rckTom/RTVC/README.md

# RTVC
RTVC (Rocket Thrust Vector Control)
