rckTom/RTVC/Documentation/99_SOFEX_2018_praesentation/SOFEX_2018_praesentation.pdf

# Entwicklung einer Modellrakete mit Schubvektorsteuerung

# Oliver Arend¹

1Solaris-RMB e.V.

# Göttingen, 11. Februar 2018

Oliver Arend, Solaris-RMB e.V. | Schubvektorsteuerung | 2018–02–11 | 1 / 22

# Übersicht

1 | Zielsetzung
2 | Mechanik
3 | Elektronik
4 | Simulation
5 | Firmware
6 | Ergebnisse
Oliver Arend, Solaris-RMB e.V. | Schubvektorsteuerung | 2018–02–11 | 2 / 22

# Zielsetzung

# Aktiv stabilisierte Rakete durch Schubvektorsteuerung

Günstige, einfach erhältliche Komponenten, z. B.

## Arduino Modellbau-Servos

# Einfach nachzubauen

# Erfahrungen für größere, komplexere Raketen nutzen

# Alle notwendigen Informationen öffentlich verfügbar machen

Oliver Arend, Solaris-RMB e.V. | Schubvektorsteuerung | 2018–02–11 | 3 / 22

Was bisher geschah ...

# Vorführung einer Schubvektorrakete durch Wolfgang Lang beim Flugtag in Manching 2015 (und seitdem immer wieder)

# Mehrere Iterationen für das Strukturdesign:

Werkstoff? Balsa, Pappelsperrholz, CfK ...
Herstellung? Laserschneiden, Fräsen, ...

## Aktueller Stand: größtenteils gefrästes Flugzeugsperrholz, teilweise 3D-Druck

# Berechnung der aerodynamischen Beiwerte mit CFD

# Erstellung eines einfachen regelungstechnischen Modells

# Umsetzung in Firmware

# Probeflug

Oliver Arend, Solaris-RMB e.V. | Schubvektorsteuerung | 2018–02–11 | 4 / 22

# Einzelteile kardanische Aufhängung


Oliver Arend, Solaris-RMB e.V. | Schubvektorsteuerung | 2018–02–11 | 5 / 22

# Motorhalterung


Oliver Arend, Solaris-RMB e.V. | Schubvektorsteuerung | 2018–02–11 | 6 / 22

# Servos und Halterungen


Oliver Arend, Solaris-RMB e.V. | Schubvektorsteuerung | 2018–02–11 | 7 / 22

# Servos montiert


Oliver Arend, Solaris-RMB e.V. | Schubvektorsteuerung | 2018–02–11 | 8 / 22

# Servos und Motorhalterung


Oliver Arend, Solaris-RMB e.V. | Schubvektorsteuerung | 2018–02–11 | 9 / 22

# Stringer-Struktur

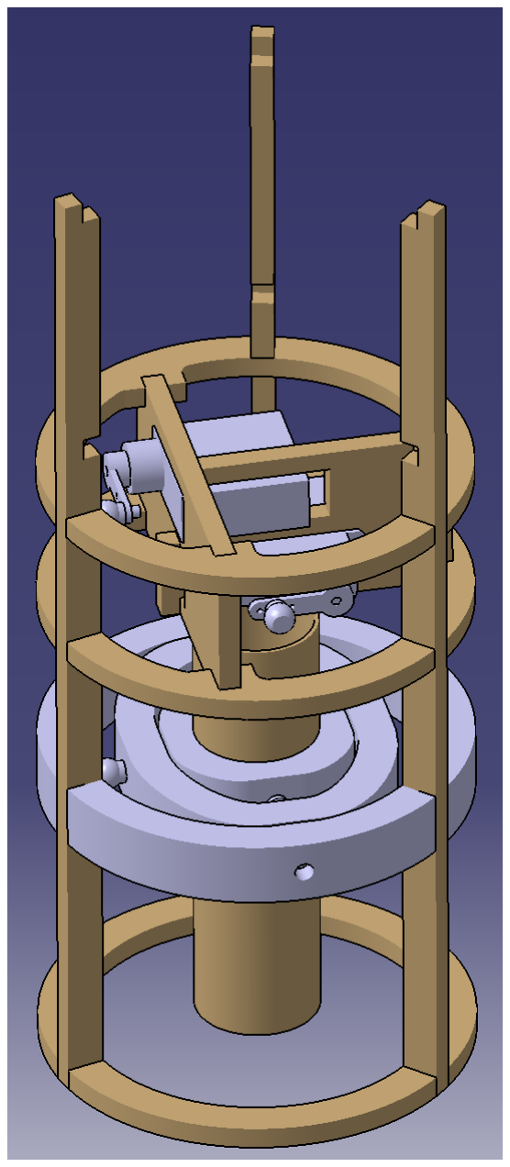
[picture p24: figure]

Oliver Arend, Solaris-RMB e.V. | Schubvektorsteuerung | 2018–02–11 | 10 / 22

# Elektronik-Komponenten


Oliver Arend, Solaris-RMB e.V. | Schubvektorsteuerung | 2018–02–11 | 11 / 22

# Elektronik montiert – ohne Kabelsalat

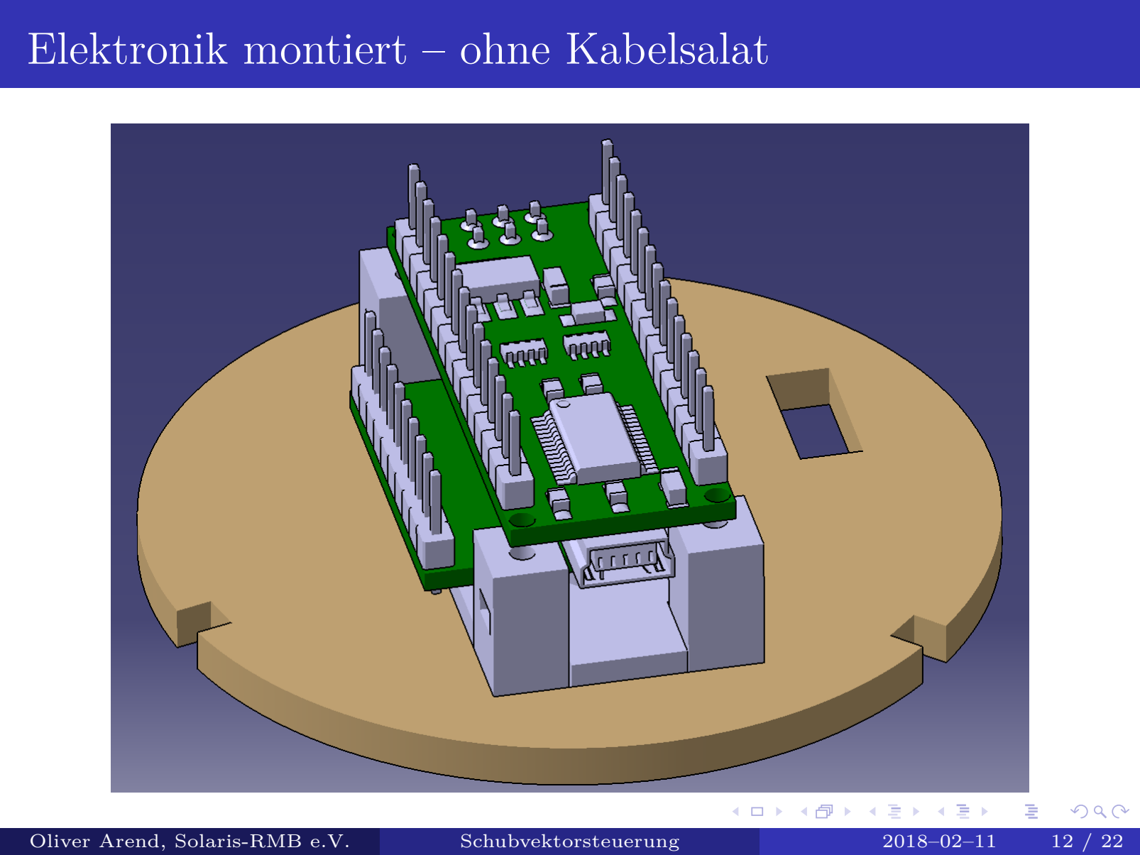
[picture p25: page 12]

Oliver Arend, Solaris-RMB e.V. | Schubvektorsteuerung | 2018–02–11 | 12 / 22

# Struktur komplett

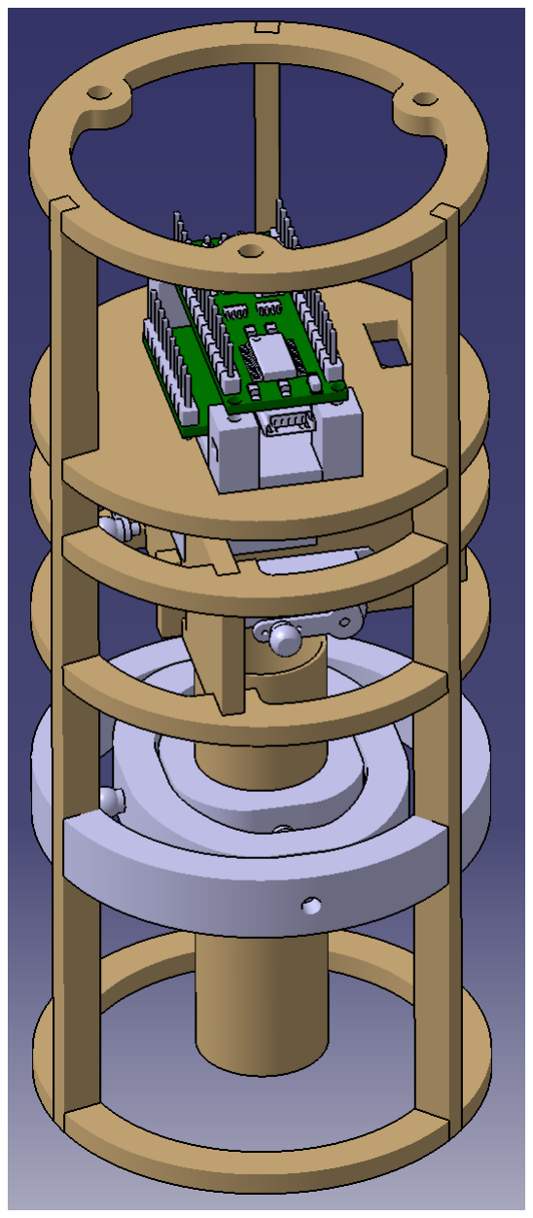
[picture p26: figure]

Oliver Arend, Solaris-RMB e.V. | Schubvektorsteuerung | 2018–02–11 | 13 / 22

# Elektronik

Batterie | BEC | Arduino Nano | GY-80 IMU
Servo X | Servo Y

# Ausstoßladung

Oliver Arend, Solaris-RMB e.V. | Schubvektorsteuerung | 2018–02–11 | 14 / 22

# Modellbildung


Oliver Arend, Solaris-RMB e.V. | Schubvektorsteuerung | 2018–02–11 | 15 / 22

# Servoverhalten


Oliver Arend, Solaris-RMB e.V. | Schubvektorsteuerung | 2018–02–11 | 16 / 22

# Vorhergesagte Reaktion auf Anstellwinkeländerung

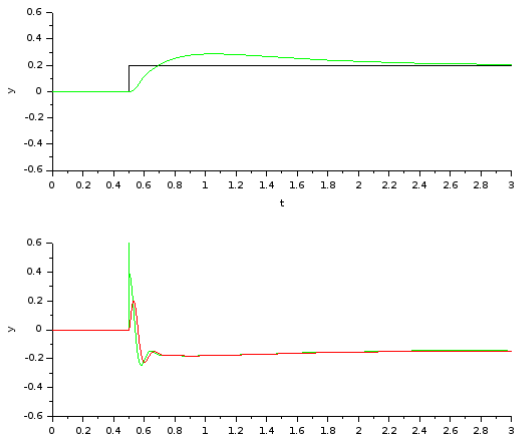
[picture p27: figure]

KP = 2,0; | KI = 1,8; | KD = 0,3
Oliver Arend, Solaris-RMB e.V. | Schubvektorsteuerung | 2018–02–11 | 17 / 22

# Firmware

# State Machine mit drei Zuständen

# Ausführen der einzelnen Operationen alle 10 ms mittels Interrupt

1 ON_RAMP Messung der Beschleunigung in z-Richtung Messung der Drehraten um x- und y-Achsen Laufende Bildung von Mittelwerten für alle Messgrößen für Korrektur der Werte im Flug Überwachen der Beschleunigung, bei Überschreiten von 20 m/s

2
| Wechsel zu IN_FLIGHT
Oliver Arend, Solaris-RMB e.V. | Schubvektorsteuerung | 2018–02–11 | 18 / 22

# Firmware

## 2 IN_FLIGHT Flugzustandsschätzung mittels Kalman-Filter Vorhersage, z. B. für Flughöhe

## ˆhi+1 = hi + ∆t vi +

1
2∆t

2
ai | (1)
vˆi+1 | = vi + ∆tai | (2)
aˆi+1 | = ai | (3)

## Korrektur

| ai+1 = (1 − Ka)ˆai+1 + Kaa˜ | | (4)

## Kalman-Gains wurden offline mit simulierten Werten ermittelt Berechnung der Soll-Position u des Servos der jeweiligen Achse anhand des Fehlers

Eγ | = Eγ + ∆t γ | (5)
| u = KP γ + KI Eγ + KD γ˙ | | (6)

## Wechsel zu RECOVERY wenn ein Bahnwinkel 90◦ überschreitet oder die Geschwindigkeit unter 0 fällt

Oliver Arend, Solaris-RMB e.V. | Schubvektorsteuerung | 2018–02–11 | 19 / 22

# Firmware

3 | RECOVERY Pin für Ausstoßladung für 1 Sekunde auf HIGH setzen Servos auf Mittelposition stellen Bis in alle Ewigkeit die LED blinken lassen ...
Oliver Arend, Solaris-RMB e.V. | Schubvektorsteuerung | 2018–02–11 | 20 / 22

# Probeflug

Werdet Ihr gleich sehen ...

Oliver Arend, Solaris-RMB e.V. | Schubvektorsteuerung | 2018–02–11 | 21 / 22

# Offene Fragen

# Sind die Servos gut geeignet (Zittern)?

# Ist die Motoransteuerung verbesserungsfähig?

# Wie kann das Design vor allem hinsichtlich Montage verbessert werden?

# Gibt es bessere (geeignete) Sensoren?

# Ist der Kalman-Filter richtig eingestellt?

# Muss der Regler besser eingestellt werden?

Oliver Arend, Solaris-RMB e.V. | Schubvektorsteuerung | 2018–02–11 | 22 / 22
