rckTom/RTVC/Design/Mechanik/teiledurchmesser.xls

 |  |  | v2 |  |  | v2.1
 | D | R |  | D | R |  | D | R
Motor außen | 24 | 12 | Motor außen | 24 | 12 | Motor außen | 24 | 12
Motorrohr außen | 25.5 | 12.75 | Motorrohr außen | 25.5 | 12.75 | Motorrohr außen | 25.5 | 12.75
Innerer Träger Kugelkopfaufnahme | 31.5 | 15.75 | Innerer Träger Ring innen | 25.5 | 12.75 | Innerer Träger Ring innen | 25.5 | 12.75
Innerer Träger Stiftaufnahme | 40.5 | 20.25 | Innerer Träger Ring außen | 31.5 | 15.75 | Innerer Träger Ring außen | 31.5 | 15.75
Äußerer Träger innen | 42.5 | 21.25 | Innerer Träger Kugelkopf | 40.5 | 20.25 | Innerer Träger Kugelkopf | 40.5 | 20.25
Äußerer Träger Kugelkopfaufnahme | 48.5 | 24.25 | Äußerer Träger kurze Achse innen | 33.5 | 16.75 | Äußerer Träger kurze Achse innen | 32 | 16
Äußerer Träger Stiftaufnahme | 57.5 | 28.75 | Äußerer Träger kurze Achse außen | 39.5 | 19.75 | Äußerer Träger kurze Achse außen | 28 | 14
Ringträger innen | 59.5 | 29.75 | Äußerer Träger Kugelkopf | 48.5 | 24.25 | Äußerer Träger Kugelkopf | 47 | 23.5
Ringträger außen | 74.5 | 37.25 | Äußerer Träger lange Achse innen | 42.5 | 21.25 | Äußerer Träger lange Achse innen | 42.5 | 21.25
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
