rckTom/RTVC/Documentation/rtvc.pdf

# Todo list

o | Mit der aktuellen Geometrie von Oliver abgleichen | | 2
o | Koordinatensysteme definieren | | 10
o | Welche Eulerwinkel sollen verwendet werden? Luftfahrtnorm? | | 11
o | Quaternionen beschreiben und einpflegen | | 11

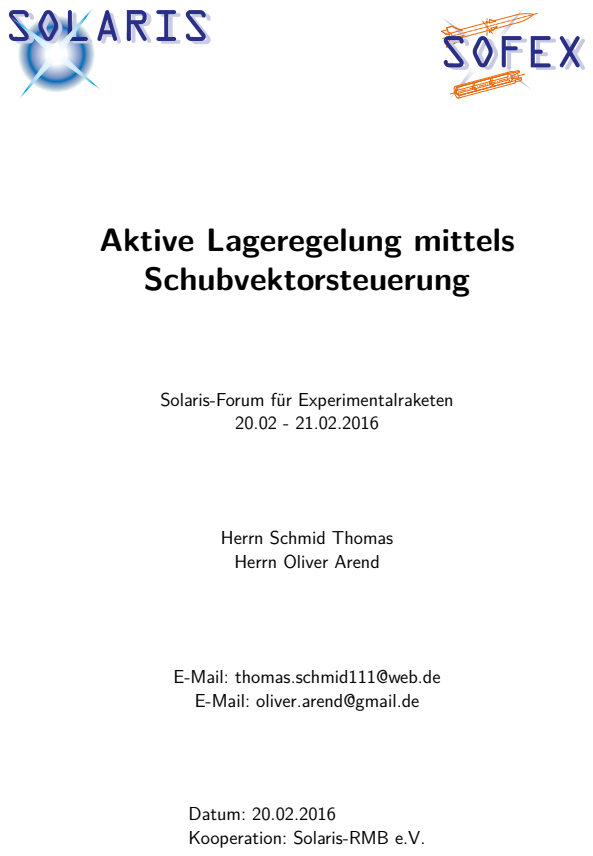
[picture p28: page 2]

Aktive Lageregelung mittels
Schubvektorsteuerung

Solaris-Forum für Experimentalraketen

Herrn Schmid Thomas
Herrn Oliver Arend

E-Mail: thomas.schmid111@web.de
E-Mail: oliver.arend@gmail.de

Datum: 20.02.2016
Kooperation: Solaris-RMB e.V.

# Zusammenfassung - Abstract

ii

# Inhaltsverzeichnis

Abbildungsverzeichnis | v
Tabellenverzeichnis | vi
1. Einführung | 1
2. Aufbau | 2
3. Konstruktive Umsetzung | 7
4. CFD-Analyse | 8
5. Modellbildung | 10
6. Numerische Simulation | 13

iii

7. Flugregelung | A
A. Test | B

iv

# Abbildungsverzeichnis

2.1. Gimbal mit Aktuatoren. a beschreibt die Winkel und Koordiantensysteme
der kardanischen Aufhängung. b beschreibt die Servoposition bezüglich des
Ursprungs | | 3
5.1. Koordinatensystem der Rakete | | 10

v

# Tabellenverzeichnis

vi

# 1. Einführung

# 2. Aufbau

## 2.1. Schubvektorsteuerung

Eine Schubvektorsteuerung lässt sich durch verschiedene Konzepte realisieren. Im großen und Ganzen kann man den Schubvektor steuern durch . . .

- veränderliche Düsenkontur (vor allem Verwendung bei Strahltriebwerken)
- kardanische Aufhängung des gesamten Antriebs
- Strahlruder im Abstrom des Antriebs

### 2.1.1. Kinematik

Mit der aktuellen Geometrie von Oliver abgleichen

Eine kardanische Aufhängung lässt sich durch zwei konzentrisch gelagerte Ringe realisieren. Abbildung 2.1a beschreibt die Anordnung der Ringe und die Position der Aktuatoranbindungen. Punkt O und I stellen dabei die Verbindungsstellen der Aktuatoren mit dem Gimbalsystem dar.

Betrachtet man die Ringe als um das jeweils vorherige Koordinatensystem S0 bzw. S1 um den Winkel α oder β gedrehte Koordinatensystem, ergeben sich folgende Transformationsbeziehungen:

T10 = Rotx =

1 | 0 | 0
0 cos α − sin α
0 sin α cos α

- (2.1)

T21 = Roty =

cos β | 0 sin β
0 | 1 | 0
− sin β 0 cos β

- (2.2)

T20 = T21T10 =

cos β | 0 | sin β
sin α sin β | cos α − cos β sin α
− cos α sin β sin α | cos α cos β

- (2.3)

Die Punkte O und I werden über ein Gestänge mit den Servomaschinen verbunden. Die Position der Servomaschinen kann Abbildung 2.1b entnommen werden. Die Gimbalkinematik lässt sich durch ein allgemeines, nichtlineares Gleichungssystem der Form

w = f

q
mit w =

"
α
β
∈ R

W , q =

"
ϕx
ϕy
∈ R

N

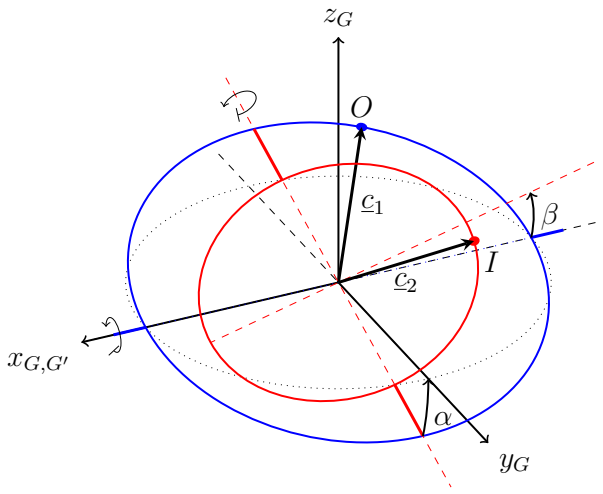
[picture p29: figure]

(a) Gimbal

A2

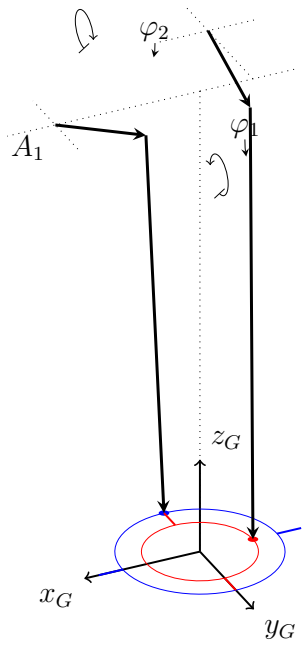
[picture p30: figure]

(b) Position der Servomaschinen

Abbildung 2.1.: Gimbal mit Aktuatoren. a beschreibt die Winkel und Koordiantensysteme der kardanischen Aufhängung. b beschreibt die Servoposition bezüglich des Ursprungs

darstellen. Der Vektor w stellt dabei die Abtriebsseitigen und der Vektor q die Antriebsseitigen Gelenkwinkel dar. Mit bekannter Länge lk der Verbindungsgestänge und bekannten Vektoren c, a, sn,0 = 0An lässt sich folgendes Gleichungssystem aufstellen:

sn = an + bn − cn | (2.4)

|bn| =

q
bn,x

2 + bn,y

2 + bn,z

2 = lk | (2.5)

Zur Beschreibung der Vektoren c und a werden folgende Gleichungen herangezogen.

an =

la,n sin qn

ay,n
la,n cos qn

- (2.6)

cn =

0Tncn,n, | mit n = 1, 2 | (2.7)

Für den äußeren Ring ergibt sich folgendes:

s1,x = la,1 sin ϕ1 + b1,x − c1,x | (2.8)
s1,y = ay,1 + b1,y − c1,y sin α + c1,z cos α | (2.9)
s1,z = la,1 cos ϕ1 + b1,z − c1,z sin α − c1,y cos α | (2.10)

lk,1 =

q
b1,x

2 + b1,y

| 2 + b1,z
| 2 | (2.11)

Die Lösung für b1,x kann direkt aus (2.8) abgelesen werden und soll im folgenden K genannt werden.

b1,x = s1,x − l1,a sin ϕ1 + c1,x = K | (2.12)

Die Gleichungen (2.9) und (2.10) nach b1,y und b1,z umgestellt ergibt

b1,y = (s1,y − a1,y)
| | {z | }
| =const=A
+c1,y cos α + c1,z sin α | (2.13)

b1,z = (s1,z − la1 sin ϕ1)
| | {z | }
| =const=B
+c1,z cos α − c1,y sin α | (2.14)

(2.15)

(2.13) und (2.14) in (2.11) eingesetzt ergibt nun:

lk,1

2 =K²
+ A

2 + 2A (c1,y cos α + c1,z sin α) + c1,y

2

cos²α + 2c1,yc,z sin α cos α + c1,z

2

sin² α

+ B

2 + 2B (c1,z cos α − c1,y sin α) + c1,z

2

cos² α − 2c1,yc,z sin α cos α + c1,y

2

sin² α

(2.16)

Umgestellt und vereinfacht ergibt sich:

lk,1

2 = K² + A
2 + B

2 + c1,z

2 + c1,y

2
| | {z | }
| =const=C

+ 2A (c1,y cos α + c1,z sin α) + 2B (c1,z cos α − c1,y sin α)

(2.17)

lk,1

2 = C + (2A c1,z − 2B c1,y) sin α + (2A c1,y + 2B c1,z) cos α | (2.18)

Gleichung (2.18) nach sin α liefert:

sin α =

lk

2 − C

2 (A c1,z − B c1,y)
| | {z | }
=const=K1

−

A c1,y + B c1,z

A c1,z − B c1,y
| | {z | }
=const=K2
cos α | (2.19)
(2.19) quadrieren liefert:

sin² α = K1

2 − 2K1K2 cos α + K2

2
cos² α | (2.20)

cos² α addieren:

sin² α + cos² α | | {z | }
| =1

= K1

2 − 2K1K2 cos α +

K2

2 + 1
cos² α | (2.21)

Durch lösen der quadratischen Gleichung kann die Lösung für α gefunden werde:

cos² α = z

→

K2

2 + 1
z

2 − 2K1K2z +

K1

2 − 1

= 0 | (2.22)
→ | z1,2 =

2K1K2 ±

r
4K1

2K2

2 − 4

K2

2 + 1 K1
2 − 1

2

K2
2 + 1 | (2.23)
α1,2 = arccos (z1,2) | (2.24)

Die Lösung für alpha lautet somit:

α1,2 = arccos (z1,2) | (2.25)

mit z1,2 =

2K1K2 ±

q
4K1

2K2

2 − 4 (K2 + 1) (K1 − 1)

2 (K2 + 1)
(2.26)

Für den inneren Ring ergibt sich nun:

s2,x

s2,y

s2,z

lk,2

=

la,2 sin ϕ2 + b2,x − c2,x cos β + c2,z cos α sin β − c2,y sin α sin β ay,2 + b2,y − c2,y cos α − c2,z sin α la,2 cos ϕ2 + b2,z − c2,x sin β − c2,z cos α cos β + c2,y sin α cos β
q
b2,x

2 + b2,y
2 + b2,z
2

(2.27)

## 2.2. Bergungssystem

## 2.3. Elektronik

## 2.4. Sensorik

## 2.5. Aktuatorik

## 2.6. Motor Gimbal

# 3. Konstruktive Umsetzung

# 4. CFD-Analyse

Um die Aerodynamischen Kräfte (siehe Kapitel 5.4.1) bestimmen zu können benötigt es Kenntnisse über die Aerodynamischen Beiwerte, insbesondere dem Auftriebs- und Widerstandsbeiwert.

Da sich das beschriebene Modell in einem sehr kleinen Reynoldszahlbereich bewegt ist nicht sicher ob die, im Raketenmodellbau üblichen Methoden, wie Barrowman gültig sind. Deshalb soll mittels einer CFD-Analyse die Beiwerte bestimmt werden.

Als Software soll OpenFOAM zum Einsatz kommen. OpenFOAM ist eine freie Bibliothek zum lösen von partiellen Differenzialproplemen, hauptsächlich aus dem Gebiet der Strömungsmechanik. Zum vernetzen des Rechennetz kommt cfMesh zum Einsatz. cfMesh erlaubt das erstellen von Hexaeder, Tetraeder oder Polyeder Netzen anhand aus CAD-Daten generierten Flächennetzen.

## 4.1. Rechennetz

Der Aufbau des Rechennetz kann in Abbildung ??

## 4.2. Randbedingungen und Solver

## 4.3. Ergebnisse

# 5. Modellbildung

## 5.1. Räumliche Darstellung

Um das System effizient zu beschreiben, ist es sinnvoll mehrere Koordinatensysteme einzuführen. Die Beziehung der Koordinatensysteme untereinander wird dabei über Transformationen hergestellt.

Bei den im Rahmen dieser Arbeit verwendeten Koordinatensysteme handelt es sich, sofern nicht anders angegeben, um rechtwinklige, kartesische Rechtssysteme.

Markante und wichtige Punkte innerhalb der definierten Systeme werden in Objektmatrizen zusammengefasst

### 5.1.1. Koordinatensysteme

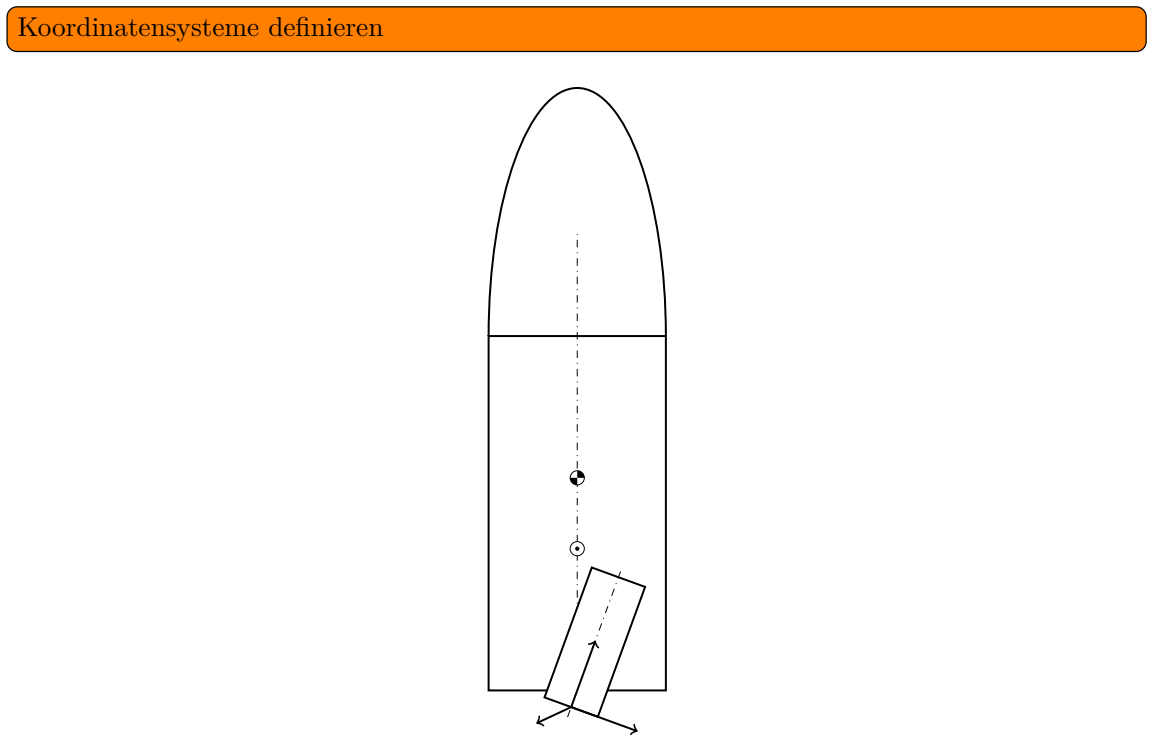
[picture p31: figure]
Koordinatensysteme definieren

Abbildung 5.1.: Koordinatensystem der Rakete

## 5.2. Räumliche Anordnung

Die Lage eines Objekts im Raum wird durch seine Position und Orientierung bestimmt und wird auch Räumliche Anordnung RAN genannt (vgl. VDI-Richtlinie 2860).

Objekte lassen sich in Form einer Objektmatrix darstellen. Eine Objektmatrix ist die Sammlung der Objektpunkte bezüglich eines Referenzkoordinatensystems. Üblicherweise wird als Referenzsystem ein Objektfestes System verwendet. Damit lässt sich die Räumliche Anordnung bezüglich einem beliebigen System mit folgendem Zusammenhang darstellen.

a{OM} =

aTb[b{OM}] | (5.1)

Wobei a{OM} die Objektmatrix bezüglich des a-Systems und aTb die Transformationsoperation vom b- ins a-System beschreibt.

### 5.2.1. Eulerwinkel

Das im Abschnitt 5.2 eingeführte Konzept zur Beschreibung der Räumlichen Anordnung lässt sich besonders einfach durch verkettete elementare Transformationsbeziehungen darstellen.
Allgemein lässt sich eine Transformation durch eine verkettete Drehung elementarer Rotationen darstellen. Auf Grund der nicht Kommutativen Multiplikation von Matrizen sind, je nach Reihenfolge der Multiplikation, die resultierende Transformationen jedoch unterschiedlich zu deuten.

aRb = Rn · Rn−1 · . . . · R1

Folgende Interpretationen sind möglich:

- Euler-Winkel (Nachmultiplikation): Multiplikation in der Reihenfolge n, n − 1, . . . , 1 Drehung immer um die momentanen Referenzachsen
- RPY-Winkel (Vormultiplikation): Multiplikation in der Reihenfolge 1, 2, . . . , n. Drehung immer um die festen Referenzachsen

In dieser Arbeit wird, sofern nicht anders angegeben, mit Euler-Winkeln gerechnet.

Welche Eulerwinkel sollen verwendet werden? Luftfahrtnorm?

### 5.2.2. Darstellung durch Quaternionen

Quaternionen beschreiben und einpflegen

### 5.2.3. Einsparen von Rechenoperationen

## 5.3. Aerodyanmik

## 5.4. Kräfte und Momente

Die resultierende Kraft RB lässt sich folgendermaßen ausdrücken:

RB = AB + F B + KB + GB | (5.2)
- AB: Aerodynamische Kräfte
- F B: Steuerkräfte
- KB: Dynamische Kräfte
- GB: Gewichtskraft

Der Momentenvektor Q ergibt sich durch:

Q = QF

+ QA

+ QK | (5.3)
- QF : Steuermomente
- QA: Aerodynamische Momente
- QK: Dynamische Momente

### 5.4.1. Aerodynamische Kräfte

### 5.4.2. Steuerkräfte

### 5.4.3. Dynamische Kräfte

## 5.5. Bewegungsgleichungen

### 5.5.1. Differentialgleichungen der translatorischen Bewegung

### 5.5.2. Differentialgleichungen der rotatorischen Bewegung

# 6. Numerische Simulation

## 6.1. Tools

## 6.2. Atmosphärenmodell

## 6.3. Implementierung

### 6.3.1. Integrationsverfahren

# 7. Flugregelung

A

# A. Test

B
