rckTom/RTVC/Documentation/01_figs/fkm-logo_1680x825_mit_Text.pdf

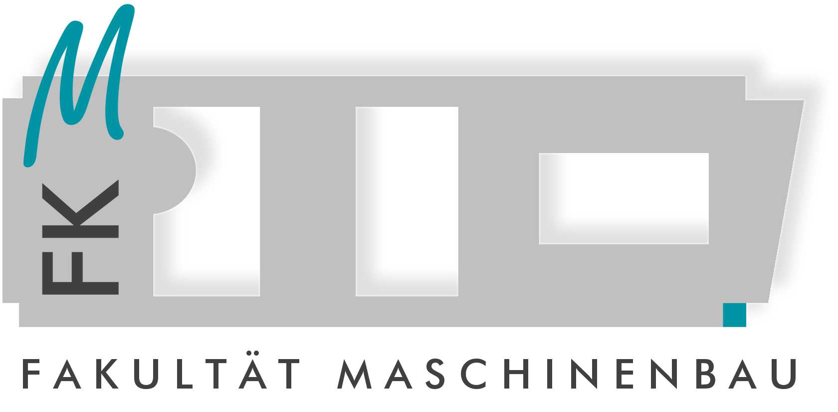
[picture p32: page 1]
