rckTom/RTVC/Design/attitude_control/kalman_filter_python/integration_bias.ods

Sheet: Tabelle1
mu_z | 10
K_a | 0,92
delta_t | 0,01024 |  |  |  |  | (1-K)a + K(z-mu_a) |  |  | (1-K)a + Kz – mu_a
t | z_real | a_real | v_real | h_real | z | a | v (K(z-mu)) | h (K(z-mu)) | a | v (Kz – mu) | h (Kz – mu)
0 | 20 | 10 | 0 | 0 | 20 | 9,2 | 0 | 0 | 8,4 | 0 | 0
0,01024 | 20 | 10 | 0,1024 | 0,000524288 | 20 | 9,936 | 0,094208 | 0,000482345 | 9,072 | 0,086016 | 0,000440402
0,02048 | 20 | 10 | 0,2048 | 0,002097152 | 20 | 9,99488 | 0,19595264 | 0,001967967 | 9,12576 | 0,17891328 | 0,00179684
0,03072 | 20 | 10 | 0,3072 | 0,004718592 | 20 | 9,9995904 | 0,298300211 | 0,004498542 | 9,1300608 | 0,272361062 | 0,004107364
0,04096 | 20 | 10 | 0,4096 | 0,008388608 | 20 | 9,999967232 | 0,400696017 | 0,008077403 | 9,130404864 | 0,365852885 | 0,00737502
0,0512 | 20 | 10 | 0,512 | 0,0131072 | 20 | 9,999997379 | 0,503095681 | 0,012704816 | 9,130432389 | 0,459348231 | 0,01160005
0,06144 | 20 | 10 | 0,6144 | 0,018874368 | 20 | 9,99999979 | 0,605495655 | 0,018380804 | 9,130434591 | 0,552843858 | 0,016782473
0,07168 | 20 | 10 | 0,7168 | 0,025690112 | 20 | 9,999999983 | 0,707895652 | 0,025105367 | 9,130434767 | 0,646339509 | 0,022922292
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
