rckTom/RTVC/Design/Mechanik/vx/Gelenklager_Igus.xlsx

Baureihe | Baugröße | Außendurchm. | Höhe Kalotte | Höhe Bund | Kippwinkel | Gewicht | Preis | Bemerkungen
KGLM-LC | KGLM-20-LC | 40 | 25 | 18 | 23 | 23.6 | 5.15 €
KGLM | KGLM-20 | 40 | 25 | 18 | 23 | 24.4 | 6.06 €
EGLM | EGLM-20 | 35 | 16 | 12 | 18 | 16.3 | 8.53 €
EGLM-LC | EGLM-20-LC | 35 | 16 | 12 | 18 | 11 | a. A.
EGFM | EGFM-20-T | 35/42 | 16 | 12 | 18 | 11.1 | 10.24 € | zum Einclipsen
ECLM-HD | ECLM-20-08-HD | 36/44 | 16 | 16 | 21 | 12 | 9.38 € | zum Einclipsen
