rckTom/RTVC/Design/Mechanik/v2.0.0/skizze_anlenkung.pptx

außerhalb des Körperrohrs

Servo 1

Servo 2

Servoarm (10 mm)

Motormount

Radius Draht (10 mm)

Anbindung MMT (+3 mm)

Mögliche Veränderungen:
- Verkürzung Anbindung auf 2 mm
- Verlängerung Draht und Servoarm auf jeweils 12 mm
