rckTom/RTVC/Design/attitude_control/kalman_filter_python/kalman_attitude_Bdirect.png

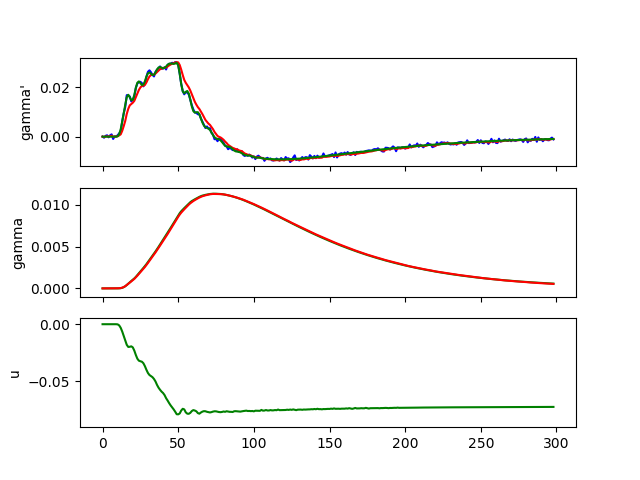
Design/attitude_control/kalman_filter_python/kalman_attitude_Bdirect.png
