rckTom/RTVC/Design/Mechanik/vx/linear_slider_length.jpg

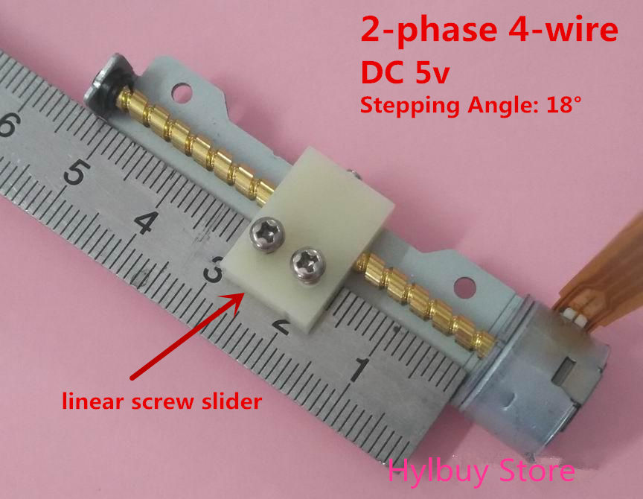
Design/Mechanik/vx/linear_slider_length.jpg
