rckTom/RTVC/Design/Mechanik/vx/linear_slider_pinout.jpg

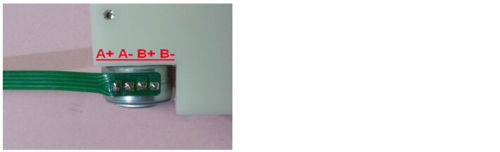
Design/Mechanik/vx/linear_slider_pinout.jpg
