rckTom/RTVC/Design/Mechanik/vx/s-l1600.jpg

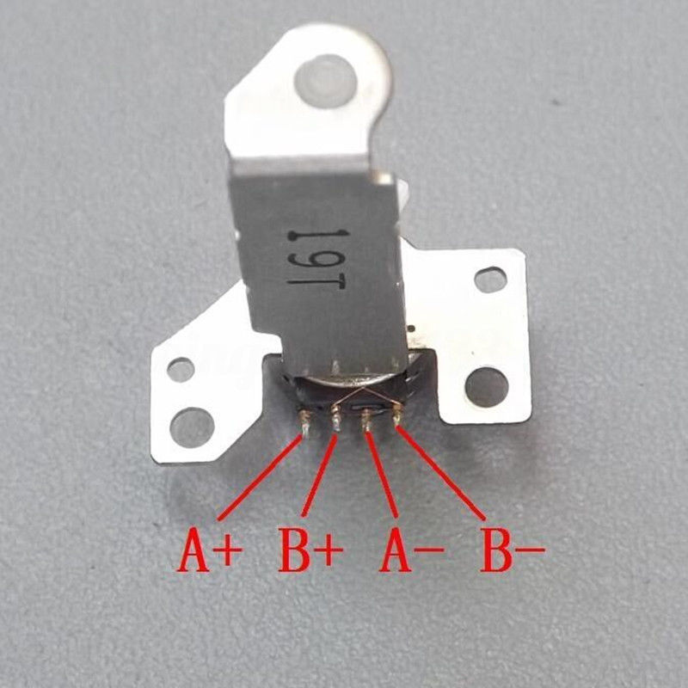
Design/Mechanik/vx/s-l1600.jpg
