rckTom/RTVC/Documentation/01_figs/sofex_grau.png

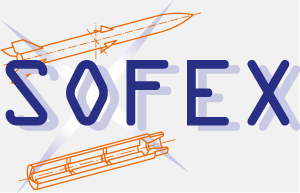
Documentation/01_figs/sofex_grau.png
