rckTom/RTVC/Simulation/02_SystemSimulation/01_SimplifiedModel/context.png

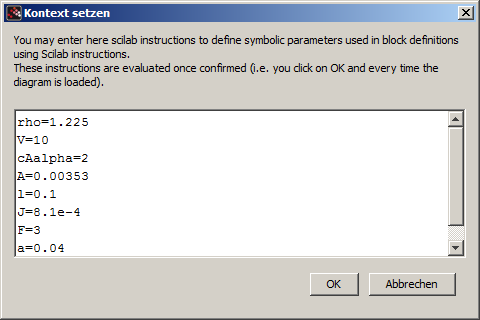
Simulation/02_SystemSimulation/01_SimplifiedModel/context.png
