rckTom/RTVC/Simulation/02_SystemSimulation/01_SimplifiedModel/PID.png

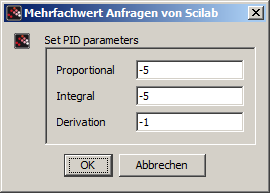
Simulation/02_SystemSimulation/01_SimplifiedModel/PID.png
