rckTom/RTVC/Software/config_app/screen_configuration_botton.png

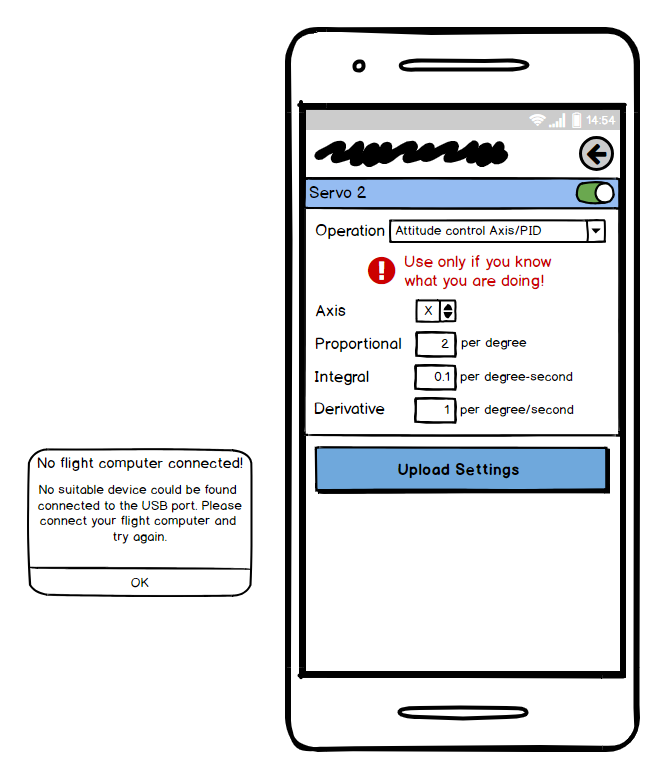
Software/config_app/screen_configuration_botton.png
