rckTom/RTVC/Software/config_app/screen_configuration_top.png

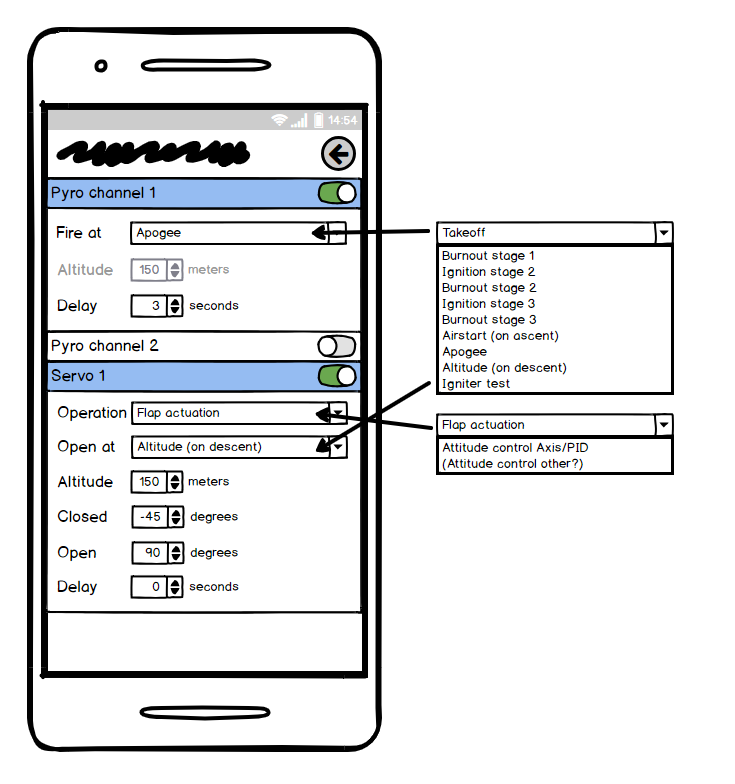
Software/config_app/screen_configuration_top.png
