rckTom/RTVC/Software/config_app/screen_list_of_configs.png

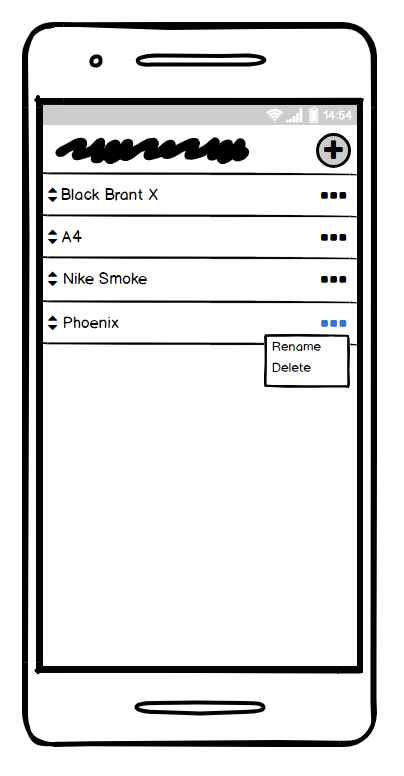
Software/config_app/screen_list_of_configs.png
