rckTom/RTVC/Design/Mechanik/v4/NC_unten.stl

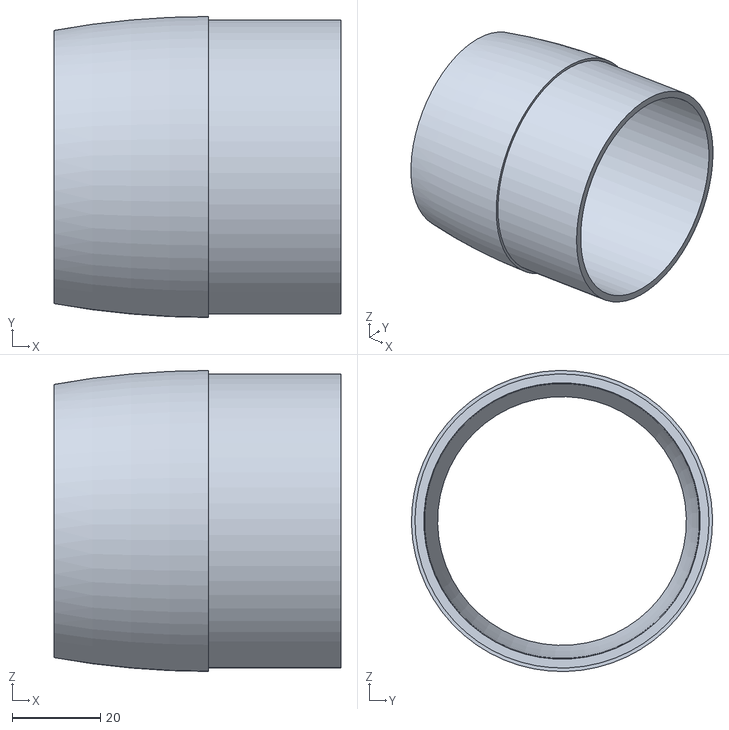
[picture p43: CAD file, 2019-12-08]
Design/Mechanik/v4/NC_unten.stl
65.0 x 68.2 x 68.2
