rckTom/RTVC/Design/Mechanik/v4/stp_export/Elektronikspant.stp

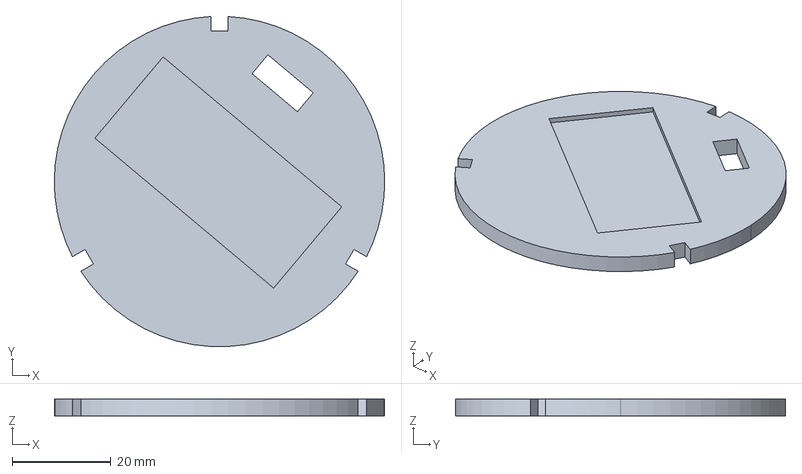
[picture p44: CAD file, 2017-12-03]
Design/Mechanik/v4/stp_export/Elektronikspant.stp
67.0 x 66.9 x 3.40 mm
