rckTom/RTVC/Design/Mechanik/vx/Igus_Pendellager_EGFM_20_T_1.stp

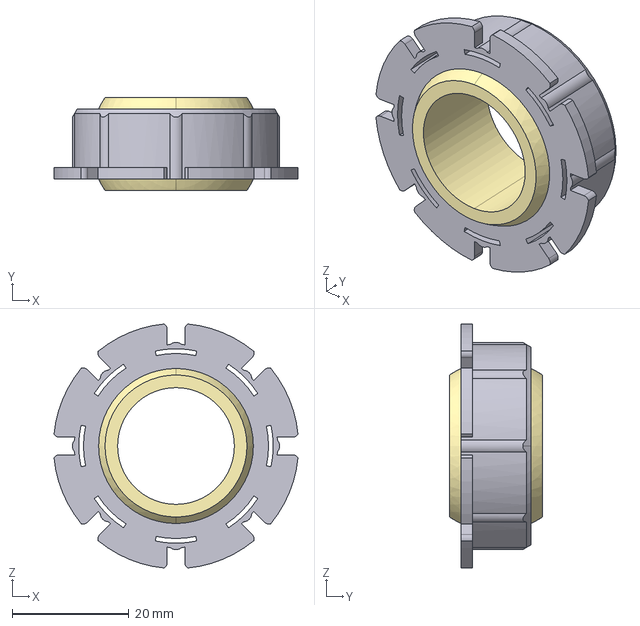
[picture p45: CAD file, 2019-12-08]
Design/Mechanik/vx/Igus_Pendellager_EGFM_20_T_1.stp
41.8 x 16.0 x 41.8 mm
