rckTom/RTVC/Simulation/01_CFD/geometry/rtvcFinal.igs

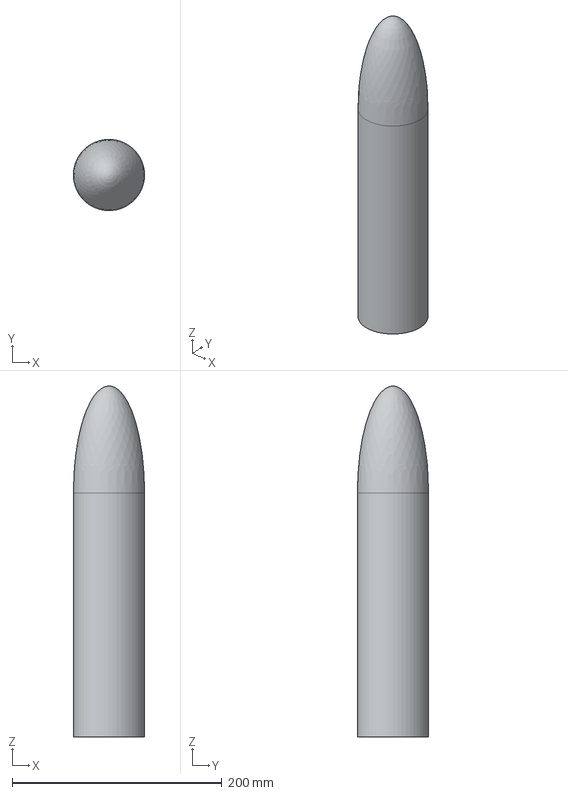
[picture p46: CAD file, 2015-11-16]
Simulation/01_CFD/geometry/rtvcFinal.igs
67.9 x 68.0 x 335.0 mm
