rckTom/RTVC/Design/Mechanik/v4/NC_oben.stl

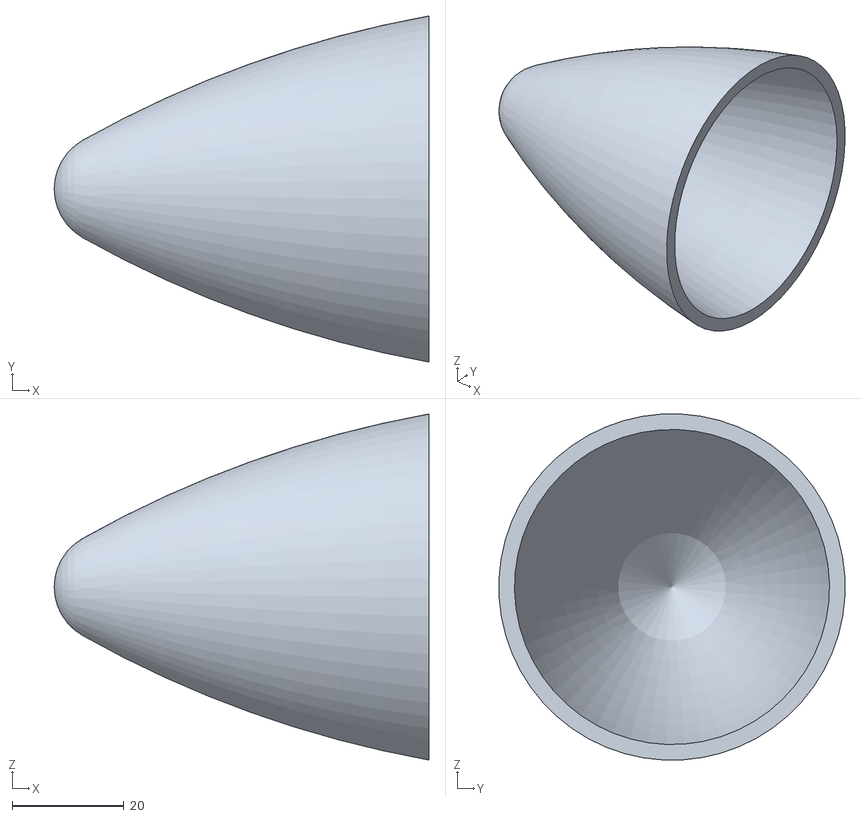
[picture p47: CAD file, 2019-12-08]
Design/Mechanik/v4/NC_oben.stl
67.0 x 61.9 x 61.9
