rckTom/RTVC/Design/Mechanik/v4/stp_export/Servotraeger_unten.stp

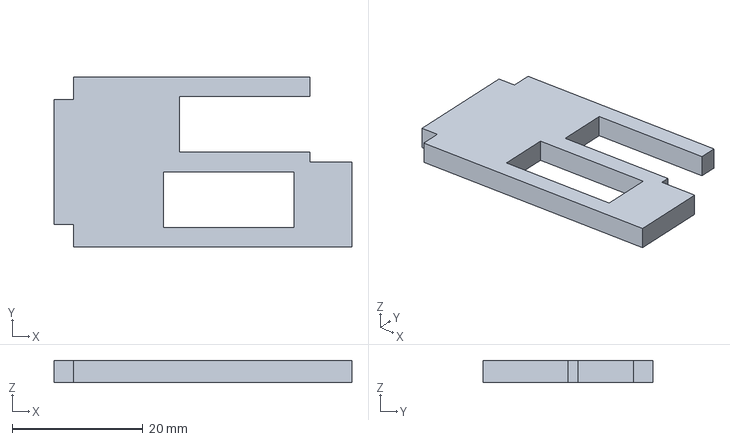
[picture p48: CAD file, 2017-12-01]
Design/Mechanik/v4/stp_export/Servotraeger_unten.stp
45.6 x 26.0 x 3.40 mm
