rckTom/RTVC/Design/Mechanik/v4/fraesteil_layout_245x200.dxf

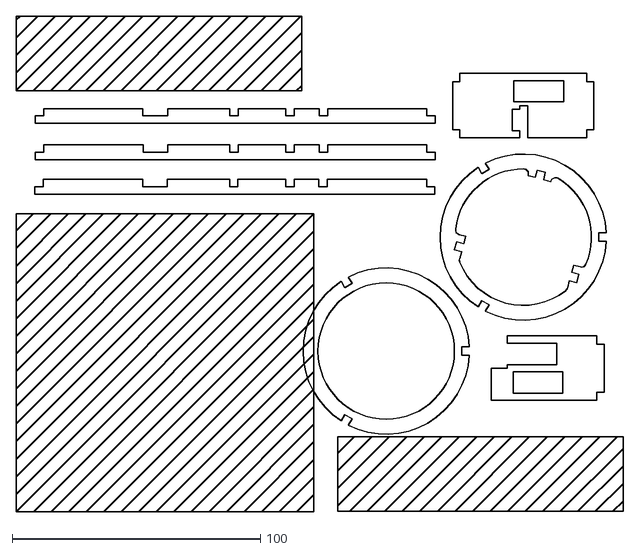
[picture p49: CAD file, 2017-12-03]
Design/Mechanik/v4/fraesteil_layout_245x200.dxf
244.6 x 199.6
