rckTom/RTVC/Design/Mechanik/v4/stp_export/Stringer.stp

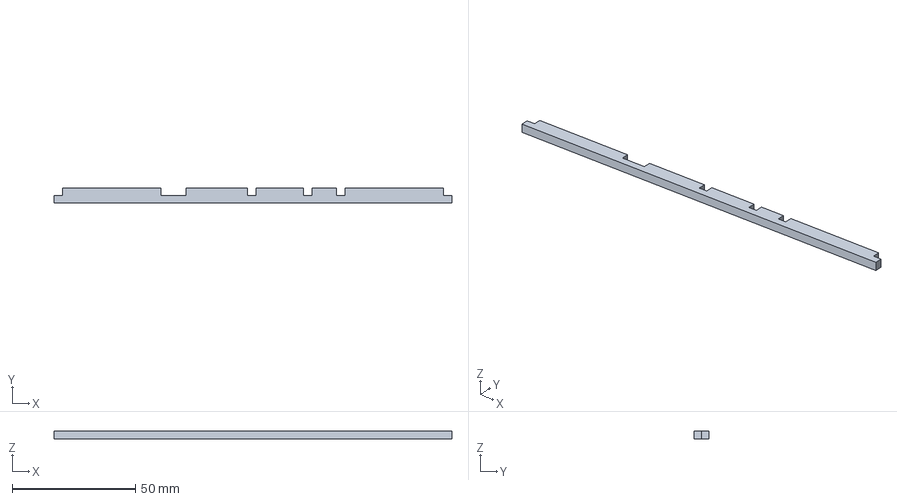
[picture p50: CAD file, 2017-12-01]
Design/Mechanik/v4/stp_export/Stringer.stp
161.2 x 6.00 x 3.40 mm
