rckTom/RTVC/Design/Mechanik/v4/fraesteil_layout_295x245.dxf

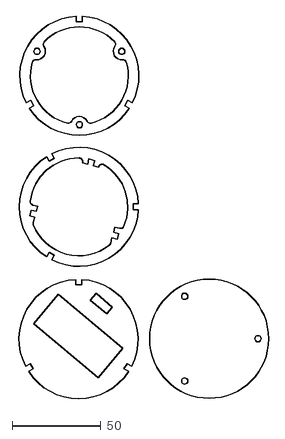
[picture p51: CAD file, 2017-12-03]
Design/Mechanik/v4/fraesteil_layout_295x245.dxf
141.9 x 215.1
