rckTom/RTVC/Design/Mechanik/v4/stp_export/Bugspant.stp

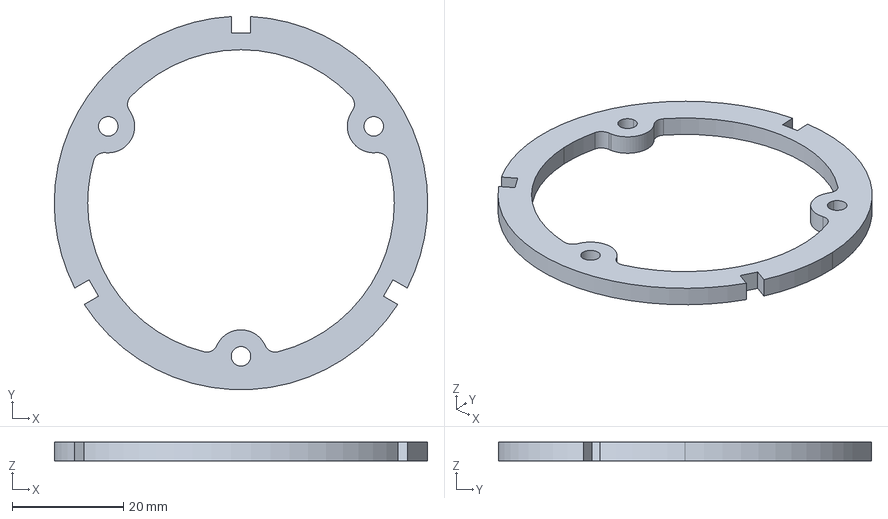
[picture p52: CAD file, 2017-12-01]
Design/Mechanik/v4/stp_export/Bugspant.stp
67.0 x 66.9 x 3.40 mm
