rckTom/RTVC/Design/Mechanik/v4/Elektroniktraeger.stl

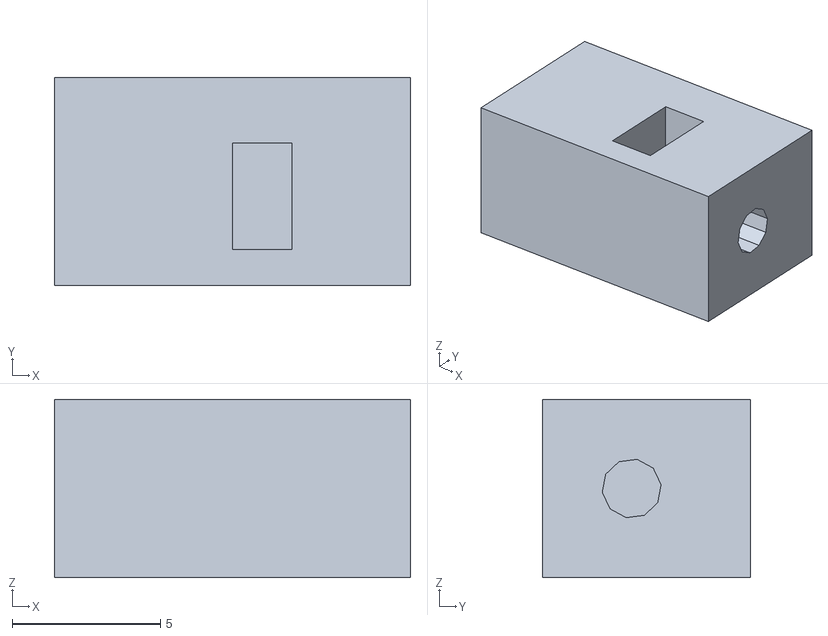
[picture p53: CAD file, 2017-12-03]
Design/Mechanik/v4/Elektroniktraeger.stl
12.0 x 7.00 x 6.00
