rckTom/RTVC/Design/Mechanik/v4/stp_export/Fallschirmspant.stp

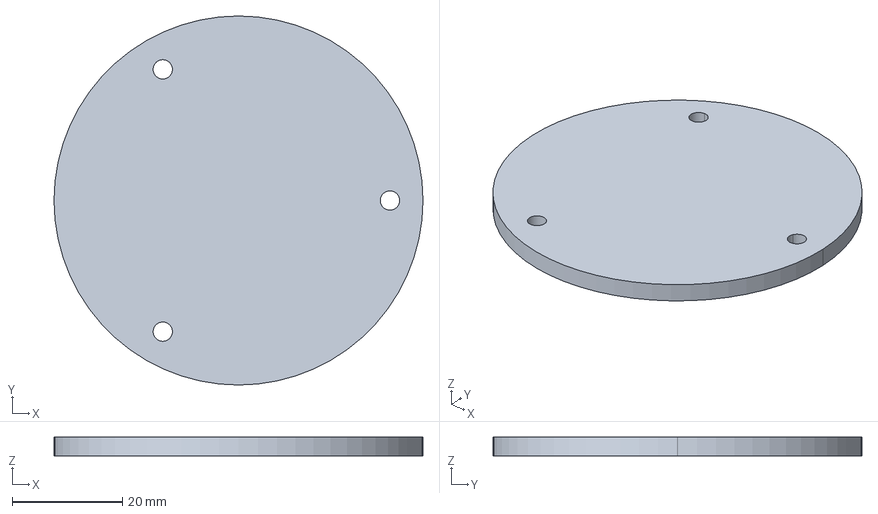
[picture p54: CAD file, 2017-12-01]
Design/Mechanik/v4/stp_export/Fallschirmspant.stp
67.0 x 67.0 x 3.40 mm
