rckTom/RTVC/Design/Mechanik/v4/Elektronikhalter.stl

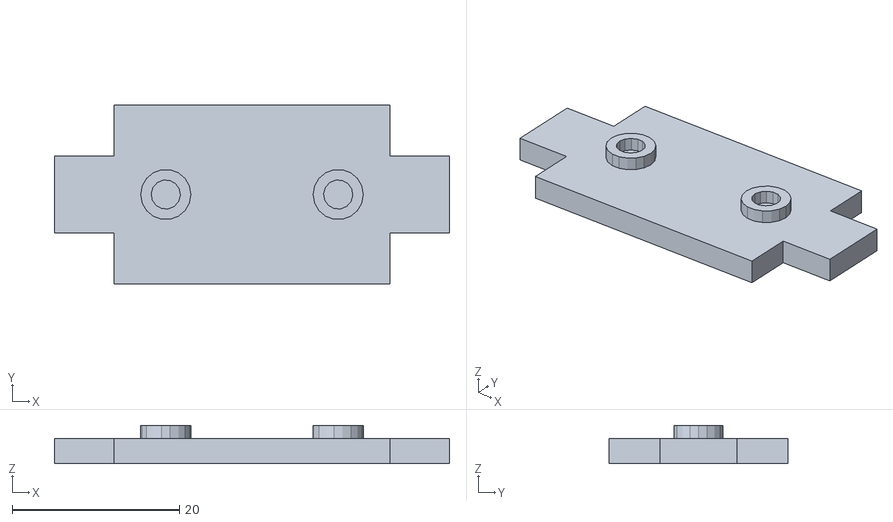
[picture p55: CAD file, 2017-12-03]
Design/Mechanik/v4/Elektronikhalter.stl
47.2 x 21.4 x 4.60
