rckTom/RTVC/Design/Mechanik/v4/stp_export/Servotraeger_oben.stp

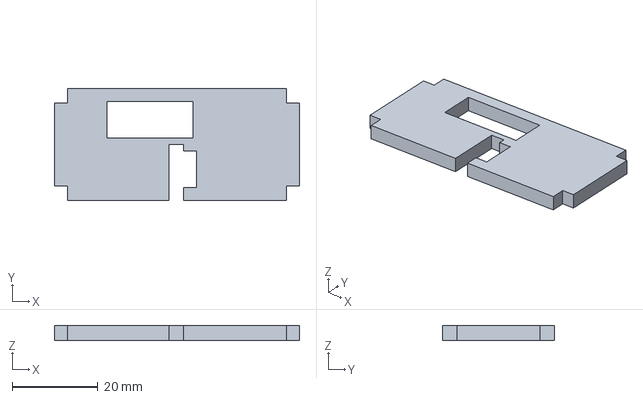
[picture p57: CAD file, 2017-12-01]
Design/Mechanik/v4/stp_export/Servotraeger_oben.stp
57.0 x 26.0 x 3.40 mm
