rckTom/RTVC/Design/Mechanik/v4/stp_export/Heckspant.stp

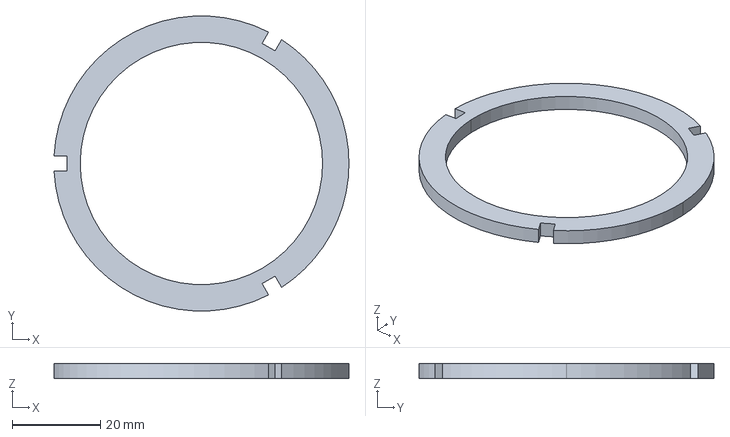
[picture p58: CAD file, 2017-12-01]
Design/Mechanik/v4/stp_export/Heckspant.stp
67.0 x 66.9 x 3.40 mm
