rckTom/RTVC/Design/Mechanik/v2.0.0/Kardanaufhaengung_Innenring.stl

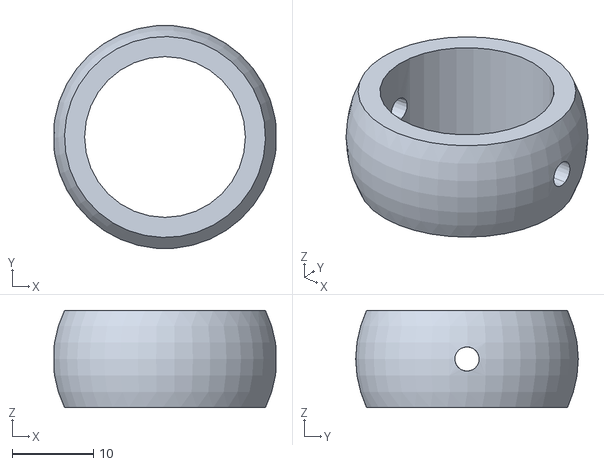
[picture p59: CAD file, 2021-02-06, an earlier design]
Design/Mechanik/v2.0.0/Kardanaufhaengung_Innenring.stl
27.3 x 27.4 x 12.0
