rckTom/RTVC/(list of files, cad)

Other CAD files:
Design/Mechanik/v1_3/RTVC_Koerper.stp
Design/Mechanik/v1/Aeussere_Aufhaengung.CATPart
Design/Mechanik/v1/Heckspant.CATPart
Design/Mechanik/v1/Innere_Aufhaengung.CATPart
Design/Mechanik/v1/Messingbuchse.CATPart
Design/Mechanik/v1/Motorrohr.CATPart
Design/Mechanik/v1/RTVC.CATProduct
Design/Mechanik/v1/Ringtraeger.CATPart
Design/Mechanik/v1/Servo_D05010MG.CATPart
Design/Mechanik/v1/Servospant_Mitte.CATPart
Design/Mechanik/v1/Servospant_oben.CATPart
Design/Mechanik/v1/Servospant_unten.CATPart
Design/Mechanik/v1/Servotraeger_oben.CATPart
Design/Mechanik/v1/Servotraeger_unten.CATPart
Design/Mechanik/v1/Stahlstift.CATPart
Design/Mechanik/v1/Stringer.CATPart
Design/Mechanik/v1_2/AT_24-40.CATPart
Design/Mechanik/v1_2/Aeussere_Aufhaengung.CATPart
Design/Mechanik/v1_2/Bugspant.CATPart
Design/Mechanik/v1_2/D3.CATPart
Design/Mechanik/v1_2/Ebayspant.CATPart
Design/Mechanik/v1_2/Fallschirmkammerboden.CATPart
Design/Mechanik/v1_2/Fallschirmkammerrohr.CATPart
Design/Mechanik/v1_2/Heckspant.CATPart
Design/Mechanik/v1_2/Innenring.CATPart
Design/Mechanik/v1_2/Innere_Aufhaengung.CATPart
Design/Mechanik/v1_2/Koerperrohr.CATPart
Design/Mechanik/v1_2/Kugelaufnahme.CATPart
Design/Mechanik/v1_2/Kugelkopf.CATPart
Design/Mechanik/v1_2/LiPo_2S_180mAh.CATPart
Design/Mechanik/v1_2/Messingrohr.CATPart
Design/Mechanik/v1_2/Mittelring.CATPart
Design/Mechanik/v1_2/Motorrohr.CATPart
Design/Mechanik/v1_2/Pro24_1G.CATPart
Design/Mechanik/v1_2/Pro24_3G.CATPart
Design/Mechanik/v1_2/RTVC.CATProduct
Design/Mechanik/v1_2/Ringtraeger.CATPart
Design/Mechanik/v1_2/Rohraufnahme.CATPart
Design/Mechanik/v1_2/Servo_D05010MG.CATPart
Design/Mechanik/v1_2/Servohebel.CATPart
Design/Mechanik/v1_2/Servospant_Mitte.CATPart
Design/Mechanik/v1_2/Servospant_oben.CATPart
Design/Mechanik/v1_2/Servospant_unten.CATPart
Design/Mechanik/v1_2/Servotraeger_oben.CATPart
Design/Mechanik/v1_2/Servotraeger_unten.CATPart
Design/Mechanik/v1_2/Spitze.CATPart
Design/Mechanik/v1_2/Stahlstift.CATPart
Design/Mechanik/v1_2/Stringer.CATPart
Design/Mechanik/v1_3/AT_24-40.CATPart
Design/Mechanik/v1_3/Aussenring.CATPart
Design/Mechanik/v1_3/Bugspant.CATPart
Design/Mechanik/v1_3/D3.CATPart
Design/Mechanik/v1_3/Ebayspant.CATPart
Design/Mechanik/v1_3/Fallschirmkammerboden.CATPart
Design/Mechanik/v1_3/Fallschirmkammerrohr.CATPart
Design/Mechanik/v1_3/Heckspant.CATPart
Design/Mechanik/v1_3/Innenring.CATPart
Design/Mechanik/v1_3/Kardanische_Aufhaengung.CATProduct
Design/Mechanik/v1_3/Koerperrohr.CATPart
Design/Mechanik/v1_3/Kugelkopf.CATPart
Design/Mechanik/v1_3/Mittelring.CATPart
Design/Mechanik/v1_3/Mittelring_Zusammenbau.CATProduct
Design/Mechanik/v1_3/Motorrohr.CATPart
Design/Mechanik/v1_3/Motorrohr_18mm.CATPart
Design/Mechanik/v1_3/RTVC.CATProduct
Design/Mechanik/v1_3/RTVC_Koerper.CATPart
Design/Mechanik/v1_3/RTVC_Laserteile_Pappel_3mm_1.dxf
Design/Mechanik/v1_3/RTVC_Laserteile_Pappel_3mm_1_beschriftet.dxf
Design/Mechanik/v1_3/RTVC_Laserteile_Pappel_3mm_2.dxf
Design/Mechanik/v1_3/RTVC_Laserteile_Pappel_3mm_2_beschriftet.dxf
Design/Mechanik/v1_3/RTVC_Laserteile_Pappel_Spaltmasstest.dxf
Design/Mechanik/v1_3/Rohraufnahme.CATPart
Design/Mechanik/v1_3/Servo_D05010MG.CATPart
Design/Mechanik/v1_3/Servohebel.CATPart
Design/Mechanik/v1_3/Servospant_Mitte.CATPart
Design/Mechanik/v1_3/Servospant_oben.CATPart
Design/Mechanik/v1_3/Servospant_unten.CATPart
Design/Mechanik/v1_3/Servotraeger_oben.CATPart
Design/Mechanik/v1_3/Servotraeger_unten.CATPart
Design/Mechanik/v1_3/Spaltmasstest.CATPart
Design/Mechanik/v1_3/Stahlstift.CATPart
Design/Mechanik/v1_3/Stringer.CATPart
Design/Mechanik/v2.0.0/Bodytube.CATPart
Design/Mechanik/v2.0.0/Elektroniktraegerplatte.CATPart
Design/Mechanik/v2.0.0/Federkraftklemme_AST_02_3,5.CATPart
Design/Mechanik/v2.0.0/Fraesteile.dxf
Design/Mechanik/v2.0.0/Kardanaufhaengung_Aussenring.CATPart
Design/Mechanik/v2.0.0/Kardanaufhaengung_Aussenring.stl
Design/Mechanik/v2.0.0/Kardanaufhaengung_Innenring.CATPart
Design/Mechanik/v2.0.0/Kardanaufhaengung_Mittelring.CATPart
Design/Mechanik/v2.0.0/Kardanaufhaengung_Mittelring.stl
Design/Mechanik/v2.0.0/LiPo_2S_180mAh.CATPart
Design/Mechanik/v2.0.0/Motorrohr.CATPart
Design/Mechanik/v2.0.0/Motorrohr_Anlenkung.CATPart
Design/Mechanik/v2.0.0/Motorrohr_Anlenkung.stl
Design/Mechanik/v2.0.0/Nosecone.CATPart
Design/Mechanik/v2.0.0/Nosecone.stl
Design/Mechanik/v2.0.0/PCB.CATPart
Design/Mechanik/v2.0.0/RTVC.CATProduct
Design/Mechanik/v2.0.0/Schalterhalterung.CATPart
Design/Mechanik/v2.0.0/Schalterhalterung.stl
Design/Mechanik/v2.0.0/Schiebeschalter.CATPart
Design/Mechanik/v2.0.0/Servo_D05010MG.CATPart
Design/Mechanik/v2.0.0/Servohebel.CATPart
Design/Mechanik/v2.0.0/Stringer.CATPart
Design/Mechanik/v2.0.0/Zentrierring_Elektronik_oben.CATPart
Design/Mechanik/v2.0.0/Zentrierring_Elektronik_unten.CATPart
Design/Mechanik/v2.0.0/Zentrierring_Heck.CATPart
Design/Mechanik/v2.0.0/Zentrierring_Servos.CATPart
Design/Mechanik/v2.0.0/Zentrierring_oben.CATPart
Design/Mechanik/v2/Aeussere_Aufhaengung.CATPart
Design/Mechanik/v2/Aeussere_Aufhaengung.stp
Design/Mechanik/v2/Bugspant.CATPart
Design/Mechanik/v2/Ebayspant.CATPart
Design/Mechanik/v2/Fallschirmkammerboden.CATPart
Design/Mechanik/v2/Heckspant.CATPart
Design/Mechanik/v2/Innere_Aufhaengung.CATPart
Design/Mechanik/v2/Innere_Aufhaengung.stp
Design/Mechanik/v2/Kugelkopf.CATPart
Design/Mechanik/v2/RTVC.CATProduct
Design/Mechanik/v2/RTVC_v2.stp
Design/Mechanik/v2/Ringtraeger.CATPart
Design/Mechanik/v2/Ringtraeger.stp
Design/Mechanik/v2/Servospant_Mitte.CATPart
Design/Mechanik/v2/Servospant_oben.CATPart
Design/Mechanik/v2/Servospant_unten.CATPart
Design/Mechanik/v2/Servotraeger_oben.CATPart
Design/Mechanik/v2/Servotraeger_unten.CATPart
Design/Mechanik/v2/Stringer.CATPart
Design/Mechanik/v3/Aussenring.CATPart
Design/Mechanik/v3/Aussenring.stl
Design/Mechanik/v3/Bugspant.CATPart
Design/Mechanik/v3/Elektronikhalter.CATPart
Design/Mechanik/v3/Elektronikhalter.stl
Design/Mechanik/v3/Elektronikhalter_Tesselierung.stl
Design/Mechanik/v3/Elektronikrahmen.CATPart
Design/Mechanik/v3/Elektronikspant.CATPart
Design/Mechanik/v3/Heckspant.CATPart
Design/Mechanik/v3/IMU_Quick.SLDPRT
Design/Mechanik/v3/Innenring.stl
Design/Mechanik/v3/Kugelaufnahme.CATPart
Design/Mechanik/v3/Laserteile_Balsa_3mm_Blatt__1.dxf
Design/Mechanik/v3/Laserteile_Balsa_3mm_Blatt__2.dxf
Design/Mechanik/v3/Laserteile_Balsa_3mm_Blatt__3.dxf
Design/Mechanik/v3/Laserteile_Balsa_3mm_Blatt__4.dxf
Design/Mechanik/v3/Mittelring.stl
Design/Mechanik/v3/Motorrohr_24mm.CATPart
Design/Mechanik/v3/NanoV3 v4.CATProduct
Design/Mechanik/v3/NanoV3 v4.step
Design/Mechanik/v3/RTVC.CATProduct
Design/Mechanik/v3/Servospant_Mitte.CATPart
Design/Mechanik/v3/Servospant_oben.CATPart
Design/Mechanik/v3/Servospant_unten.CATPart
Design/Mechanik/v3/Servotraeger_oben.CATPart
Design/Mechanik/v3/Servotraeger_unten.CATPart
Design/Mechanik/v3/Spitze.CATPart
Design/Mechanik/v3/Stringer.CATPart
Design/Mechanik/v4/Aussenring.CATPart
Design/Mechanik/v4/Bugspant.CATPart
Design/Mechanik/v4/Chip.CATPart
Design/Mechanik/v4/Crystal.CATPart
Design/Mechanik/v4/Elektronikbaugruppe.CATProduct
Design/Mechanik/v4/Elektronikhalter.CATPart
Design/Mechanik/v4/Elektronikspant.CATPart
Design/Mechanik/v4/Elektroniktraeger.CATPart
Design/Mechanik/v4/Fallschirmspant.CATPart
Design/Mechanik/v4/Gleitlager_3x4,5x3.CATPart
Design/Mechanik/v4/Heckspant.CATPart
Design/Mechanik/v4/IMU_GY-80.CATPart
Design/Mechanik/v4/Innenring.CATPart
Design/Mechanik/v4/Koerperrohr_oben.CATPart
Design/Mechanik/v4/Koerperrohr_unten.CATPart
Design/Mechanik/v4/Kugelkopf.CATPart
Design/Mechanik/v4/Led (1).CATPart
Design/Mechanik/v4/Led.CATPart
Design/Mechanik/v4/Mittelring.CATPart
Design/Mechanik/v4/Motorhalterung.CATProduct
Design/Mechanik/v4/Motorrohr_18mm.CATPart
Design/Mechanik/v4/NanoV3 v4.CATProduct
Design/Mechanik/v4/PCB_1.CATPart
Design/Mechanik/v4/Pin (1).CATPart
Design/Mechanik/v4/Pin.CATPart
Design/Mechanik/v4/RTVC_v4.CATProduct
Design/Mechanik/v4/Res.CATPart
Design/Mechanik/v4/Servo_D05010MG.CATPart
Design/Mechanik/v4/Servobaugruppe.CATProduct
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
