rckTom/RTVC/Software/gy-86_wiring.txt

GY-86   Arduino

VCC_IN  5V
3.3V
GND     GND
SCL     A5
SDA     A4
FSYNC
INTA    D2
DRDY
