rckTom/RTVC/Software/firmware_v2/performance.ods

Sheet: mpu_mpu+pressure
mpu only |  |  | mpu & pressure |  |  | mpu & pressure with const temp |  |  | mpu, pressure, calc response
timestamp | delta | delta / cycle | timestamp | delta | delta / cycle | timestamp | delta | delta / cycle | timestamp | delta | delta / cycle
436820 |  |  | 438200 |  |  | 428940 |  |  | 438796
705604 | 268784 | 2099.875 | 1742608 | 1304408 | 10190.6875 | 1245400 | 816460 | 6378.59375 | 1288296 | 849500 | 6636.71875
974436 | 268832 | 2100.25 | 3047180 | 1304572 | 10191.96875 | 2056992 | 811592 | 6340.5625 | 2137484 | 849188 | 6634.28125
1243288 | 268852 | 2100.40625 | 4351952 | 1304772 | 10193.53125 | 2868508 | 811516 | 6339.96875 | 2985728 | 848244 | 6626.90625
1512104 | 268816 | 2100.125 | 5656692 | 1304740 | 10193.28125 | 3680048 | 811540 | 6340.15625 | 3829072 | 843344 | 6588.625
1775988 | 263884 | 2061.59375 | 6961376 | 1304684 | 10192.84375 | 4496620 | 816572 | 6379.46875 | 4677780 | 848708 | 6630.53125
2044920 | 268932 | 2101.03125 | 8261720 | 1300344 | 10158.9375 | 5308136 | 811516 | 6339.96875 | 5521776 | 843996 | 6593.71875
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
