rckTom/RTVC/Simulation/01_CFD/results/hinterkante.png

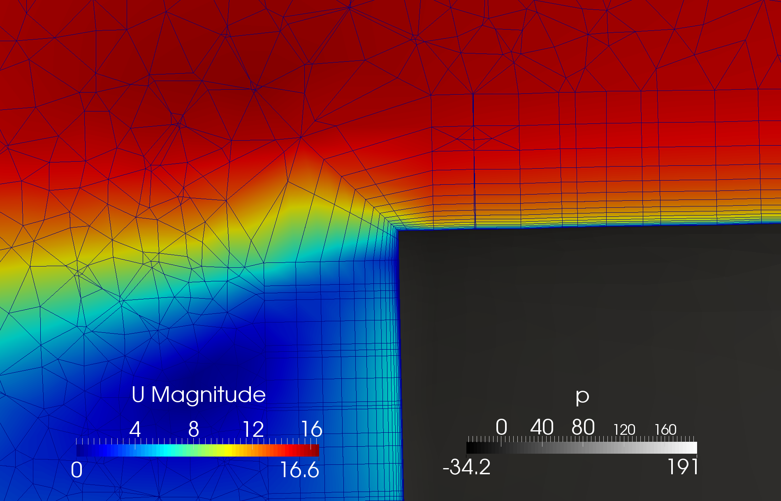
Simulation/01_CFD/results/hinterkante.png
