rckTom/RTVC/Simulation/01_CFD/results/mesh.png

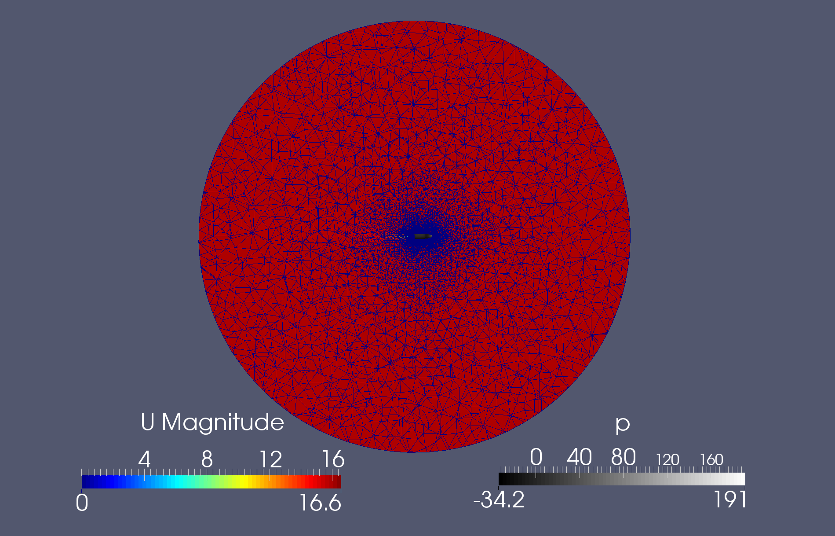
Simulation/01_CFD/results/mesh.png
