rckTom/RTVC/Simulation/01_CFD/results/rtvc5degaoa.png

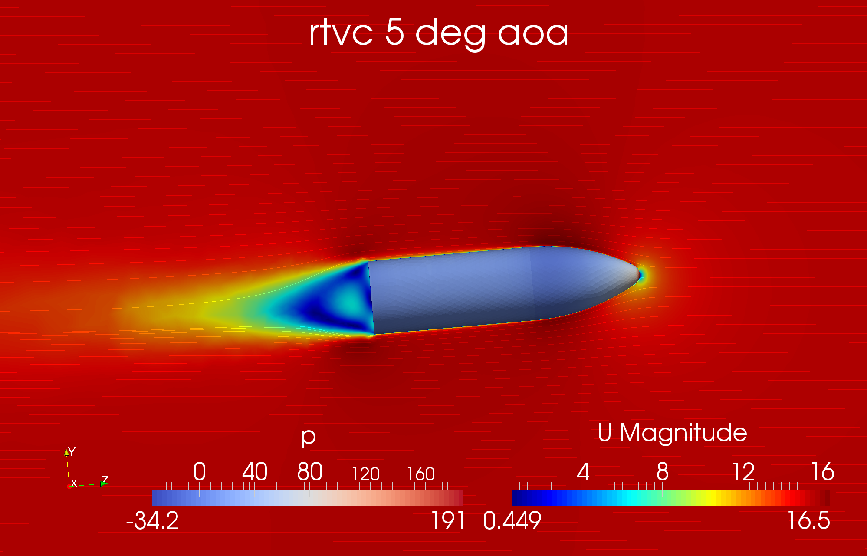
Simulation/01_CFD/results/rtvc5degaoa.png
