rckTom/RTVC/Software/config_app/all_screens.pdf

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

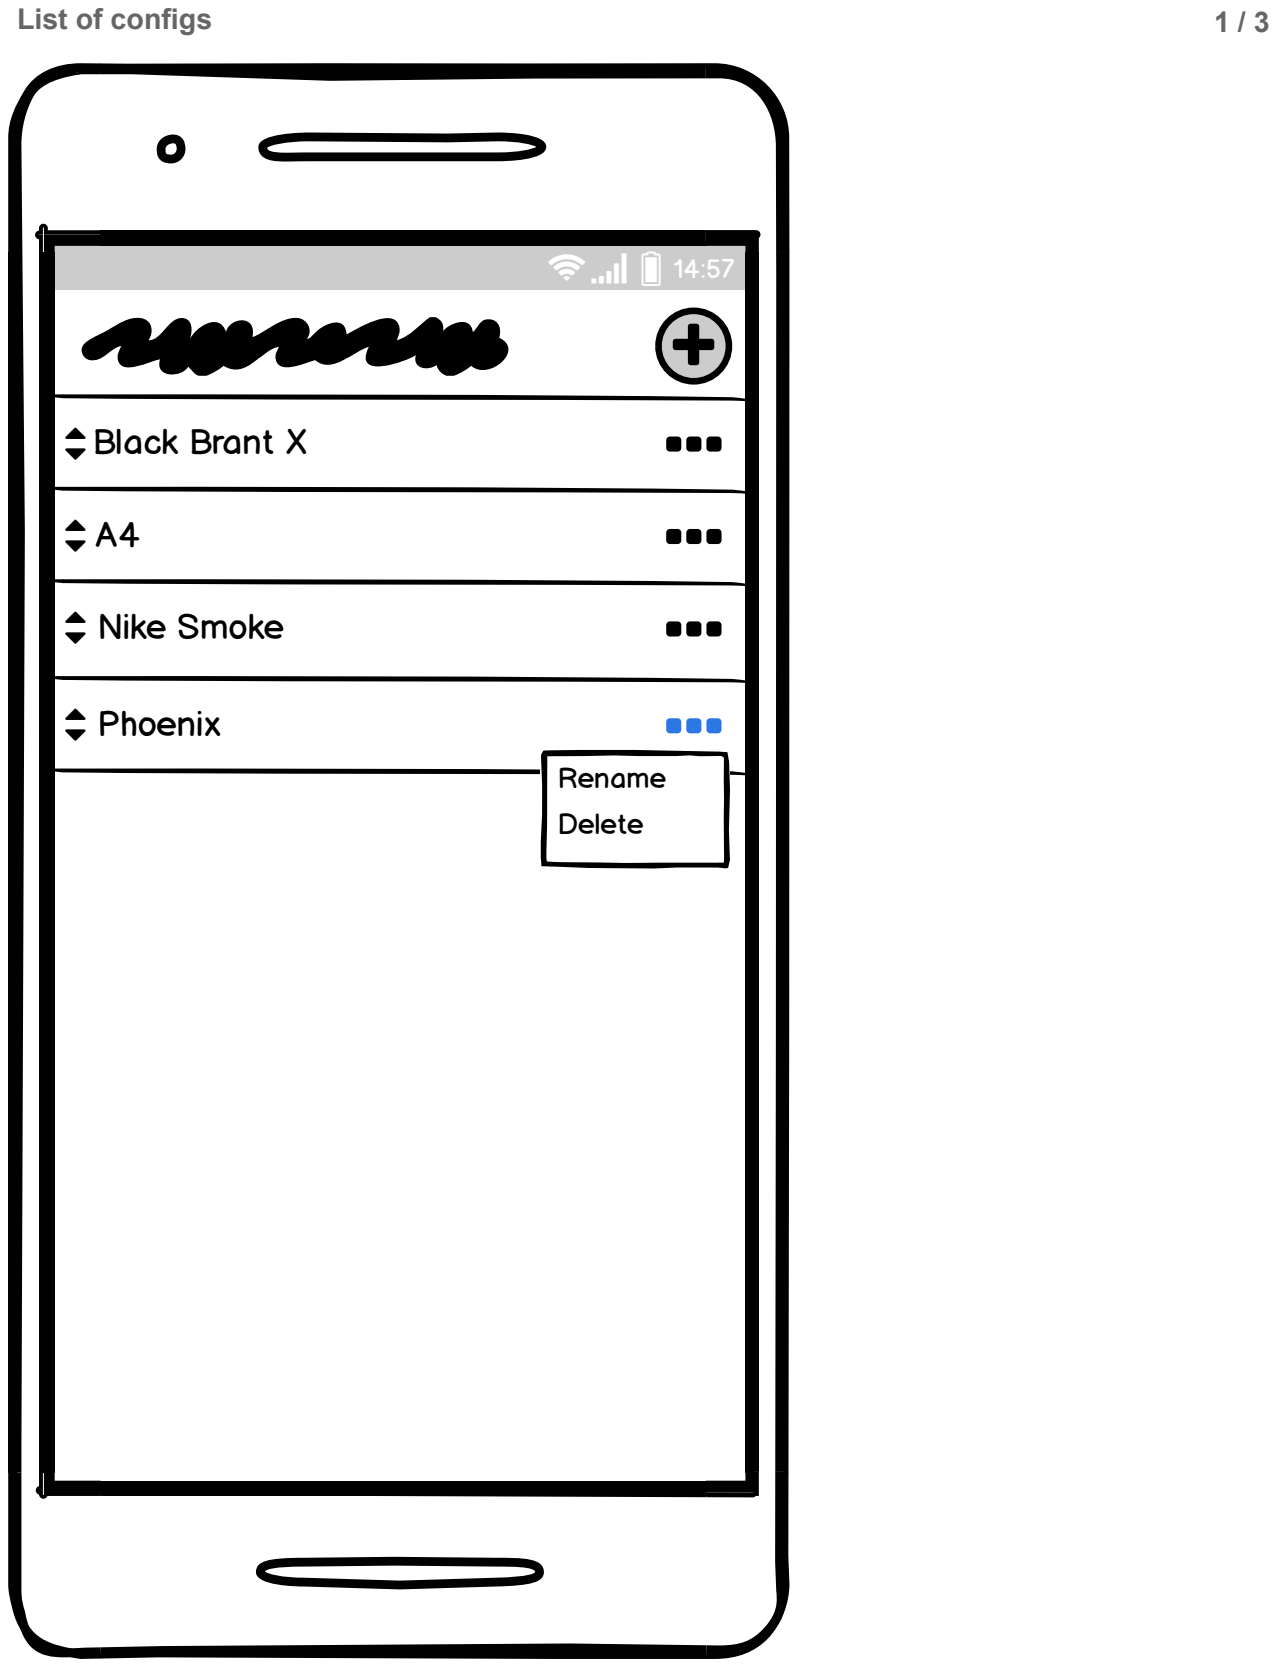
[picture p63: page 1]

### Pyro channel 1

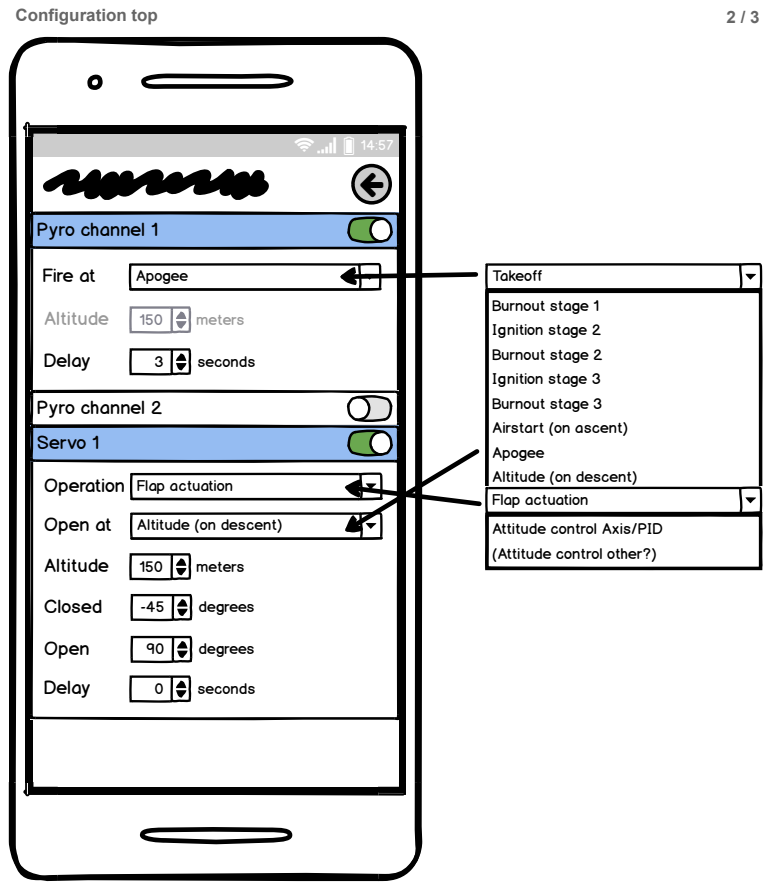
[picture p64: page 2]
Pyro channel 2; Fire at; Apogee; Altitude; Servo 1; Takeoff; Delay; meters; seconds; Open at; Altitude (on descent); Closed; degrees; Open; Configuration top

Burnout stage 1
Ignition stage 2
Burnout stage 2
Ignition stage 3
Burnout stage 3
Airstart (on ascent)
Apogee
Altitude (on descent)
Flap actuation
Igniter test
Attitude control Axis/PID
(Attitude control other?)

Operation Flap actuation

## Servo 2

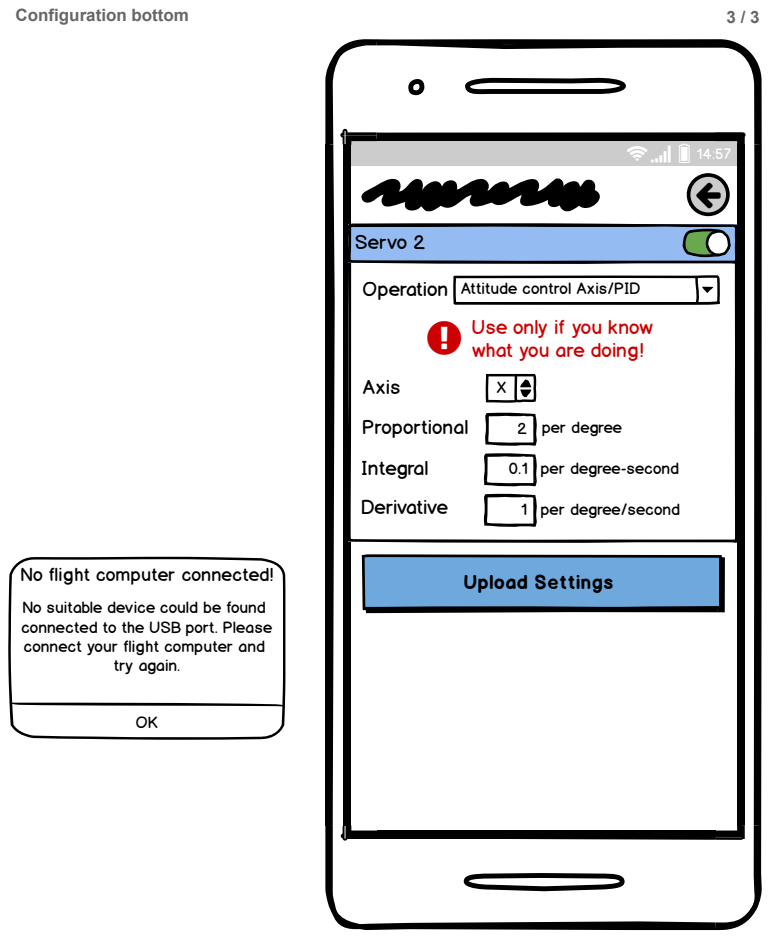
[picture p65: page 3]
Proportional; 2 per degree; Axis; Integral; 0.1 per degree-second; Derivative; 1 per degree/second; try again.; Configuration bottom

Operation Attitude control Axis/PID
what you are doing!

Use only if you know

Upload Settings No flight computer connected!

No suitable device could be found
connected to the USB port. Please
connect your flight computer and
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
