rckTom/RTVC/Documentation/01_figs/sofex.pdf

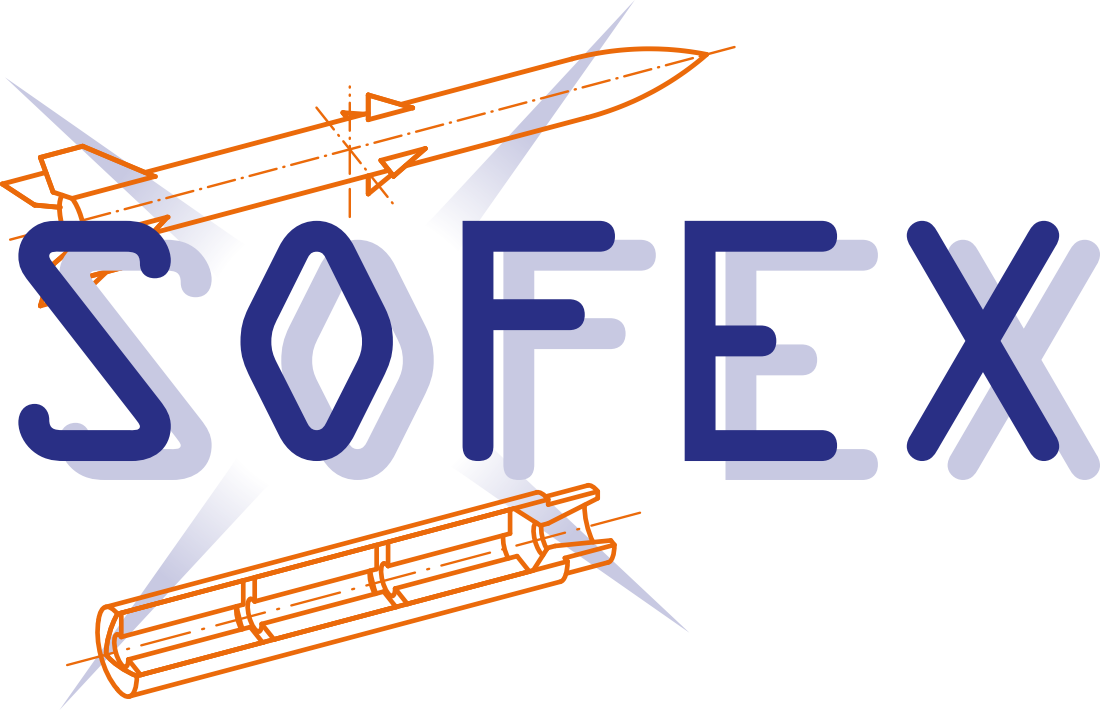
[picture p66: page 1]
