rckTom/RTVC/Documentation/01_figs/solaris.pdf

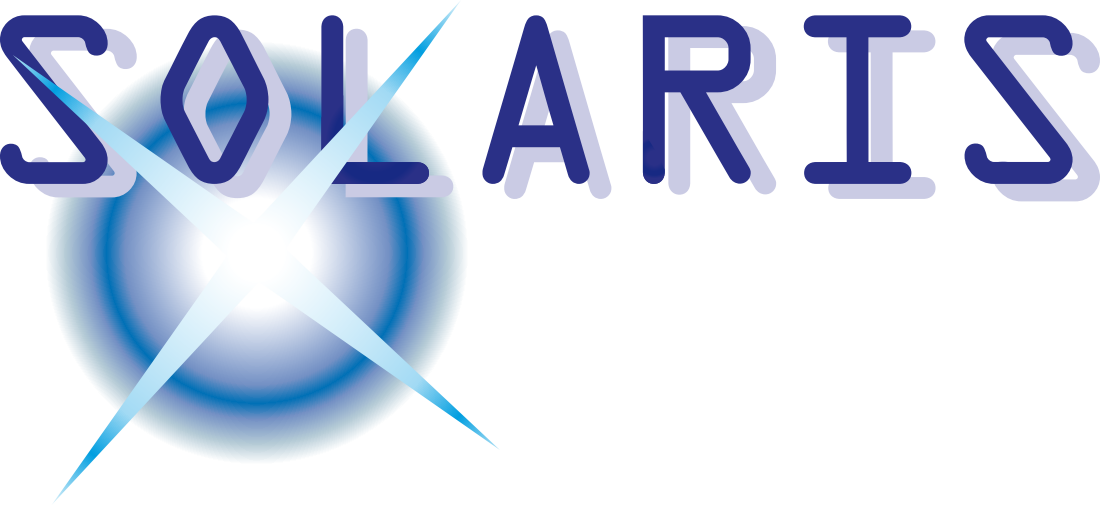
[picture p67: page 1]
