rckTom/RTVC/Simulation/02_SystemSimulation/01_SimplifiedModel/Bahnwinkel_PID-Antwort_Anstellwinkel.pdf

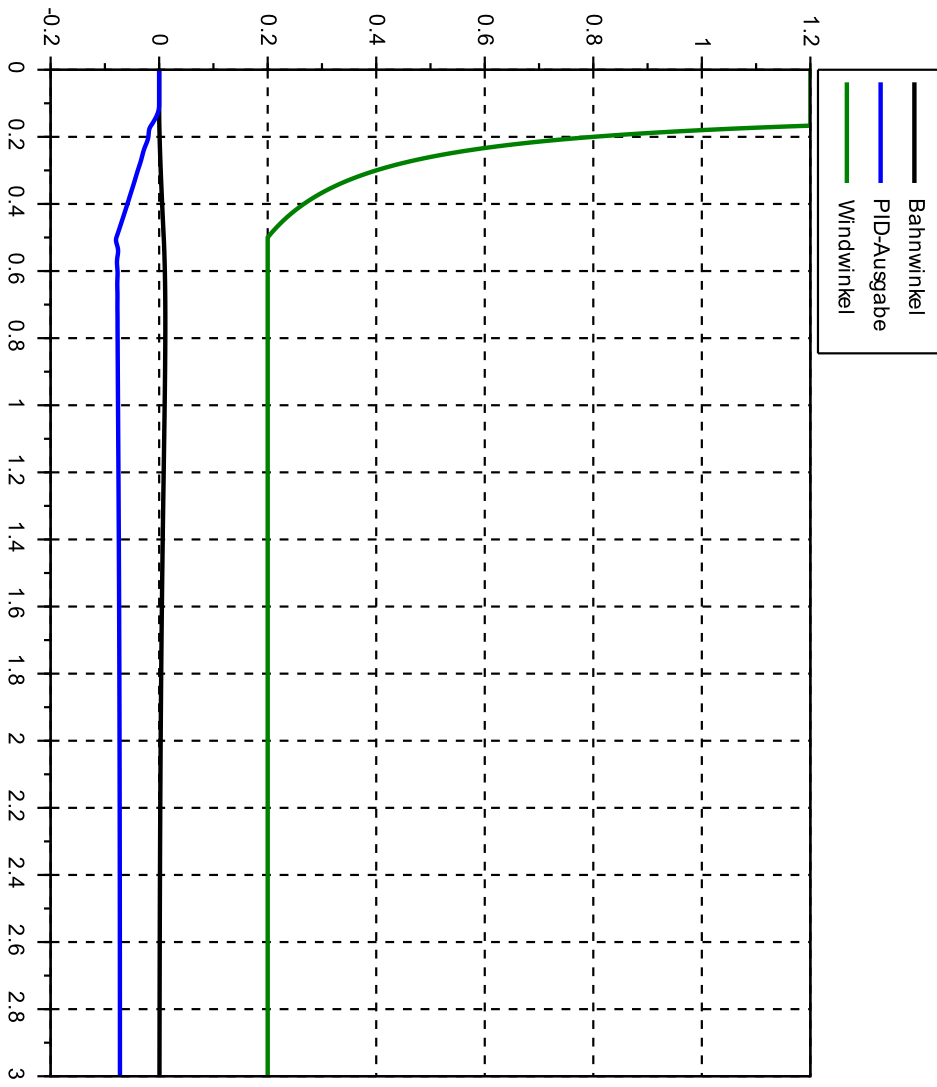
[picture p68: page 1]
