rckTom/RTVC/(list of files, drawings)

Other design files:
Design/electronics/nano_gy80_wiring_HORIZONTALLY_INVERTED.fzz
