rckTom/RTVC/(commit log)

2015-09-21 Create links.md
    Links zum Paper von Galejs und den Barrowman-Formeln
2015-11-10 Zwei Versionen der Mechanik
    Bisher noch ohne Elektronik- und Fallschirmkammer
    [AT_24-40.CATPart, Aeussere_Aufhaengung.CATPart, D3.CATPart, Heckspant.CATPart, Innere_Aufhaengung.CATPart, Kugelaufnahme.CATPart, Kugelkopf.CATPart, LiPo_2S_180mAh.CATPart]
2015-11-10 Testcode zum Servo verfahren
    Verfährt jede Sekunde um "90°" in eine Richtung. Die Servo-Library geht
    davon aus, dass ein Servo immer 180°-Bewegungsfreiheit hat. Die
    D05010MG-Servos haben nur 90°
2015-11-10 Datenblatt Servo
2015-11-10 Hinzufügen der Dokumentation
2015-11-10 Matlab/Octave Code der Gimbalkinematik
2015-11-10 keine Inhaltliche Ändernung
    [teiledurchmesser.xls]
2015-11-15 Mechanik Ordner in Design verschoben. Erste CFD Ergebnisse
    [AT_24-40.CATPart, Aeussere_Aufhaengung.CATPart, D3.CATPart, Heckspant.CATPart, Innere_Aufhaengung.CATPart, Kugelaufnahme.CATPart, Kugelkopf.CATPart, LiPo_2S_180mAh.CATPart]
2015-11-15 Mechanik inkl. Step-Datei der Assembly
    [AT_24-40.CATPart, Aeussere_Aufhaengung.CATPart, Heckspant.CATPart, Innere_Aufhaengung.CATPart, Kugelaufnahme.CATPart, Kugelkopf.CATPart, Motorrohr.CATPart, RTVC.CATProduct]
2015-11-15 Links zu Galejs und Barrowman-Formeln gelöscht, jeweils eine PDF hochgeladen
2015-11-16 Mechanik-Design fertiggestellt
    Ausnahme: genaue Positionierung und Komponenten der Elektronik (habe 30
    mm lichte Höhe vorgesehen, das sollte ja für alle Komponenten reichen),
    Schrauben zum Anbringen der Fallschirmkammer am Rest.
    [Bugspant.CATPart, Ebayspant.CATPart, Fallschirmkammerboden.CATPart, Fallschirmkammerrohr.CATPart, Koerperrohr.CATPart, RTVC.CATProduct, Spitze.CATPart, Stringer.CATPart]
2015-11-16 Mechanik-Design fertiggestellt
    (da war eine Datei noch nicht gespeichert)
    [RTVC.CATProduct]
2015-11-16 CFD Geometrie an neue Version angepasst
    [rtvc.stp, rtvcFinal.igs, rtvc_radius.stp]
2015-11-16 OpenFOAM Testcase hinzugefügt: - Netzgenerierung mit cfMesh (siehe system/meshDict) - Lösung mit simpleFoam - Postprocessing mit Paraview. Einstellungen für die Beiwerte finden sich in system/control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
2015-11-20 Kardanische Aufhängung
    Minimale Änderungen in der Teilegeometrie, STP-Dateien zur
    Formherstellung erzeugt
    [Aeussere_Aufhaengung.CATPart, Aeussere_Aufhaengung.stp, Innere_Aufhaengung.stp, RTVC.CATProduct, Ringtraeger.CATPart, Ringtraeger.stp, Stahlstift.CATPart, teiledurchmesser.xls]
2015-11-24 Kardanische Aufhängung
    Geometrie noch etwas fertigungsoptimiert (Formen fräsen, Rovings legen)
    [Aeussere_Aufhaengung.CATPart, Aeussere_Aufhaengung.stp, Innere_Aufhaengung.CATPart, Innere_Aufhaengung.stp, RTVC.CATProduct, RTVC_v2.stp, Ringtraeger.CATPart, Ringtraeger.stp]
2016-03-02 Überarbeitung Frästeilgestaltung
    Ergänzung der Aussparungen um einen Radius und eine Spaltzugabe, so dass
    Montage der gefrästen Teile vereinfacht wird. Dicke Sperrholz,
    Durchmesser Fräser und Spaltzugabe können als Parameter im Product
    geändert werden.
    [AT_24-40.CATPart, Aeussere_Aufhaengung.CATPart, Bugspant.CATPart, D3.CATPart, Ebayspant.CATPart, Fallschirmkammerboden.CATPart, Fallschirmkammerrohr.CATPart, Fraesdatei_2Saetze_480x230_ohneBeschriftung.dxf]
2016-03-19 Revert "Überarbeitung Frästeilgestaltung"
    This reverts commit 69753cf70bb31855a1c7c250a0683d025a80413d.
    [AT_24-40.CATPart, Aeussere_Aufhaengung.CATPart, Bugspant.CATPart, D3.CATPart, Ebayspant.CATPart, Fallschirmkammerboden.CATPart, Fallschirmkammerrohr.CATPart, Fraesdatei_2Saetze_480x230_ohneBeschriftung.dxf]
2016-03-19 Frästeile mit Radien und Spaltzugabe
    Nach den Problemen bei der Montage beim Sofex eine aktualisierte
    Fassung, die parametrisiert den Fräserdurchmesser sowie eine Spaltzugabe
    berücksichtigt.
    [Bugspant.CATPart, Ebayspant.CATPart, Heckspant.CATPart, RTVC.CATProduct, Ringtraeger.CATPart, Servospant_Mitte.CATPart, Servospant_oben.CATPart, Servospant_unten.CATPart]
2016-03-21 Vereinfachte Mechanik zum Lasern
    Habe die Mechanik auf Lasern von 3-mm-Pappelsperrholz ausgelegt; die
    Materialstärken und Spaltmaße sind auf mein Sperrholzbrett (Nenn 3 mm,
    Ist 3,2 mm) und den Laser hier im Hackerspace ausgelegt
    (Übergangspassung bei Montage; die Stahlstifte zur Verbindung der
    Kardanelemente laufen direkt im Holz, Verkohlung schmiert auch etwas
    ;-). Kompatibilität mit V5R17 wiederhergestellt; bitte nicht mit neueren
    Releases bearbeiten und speichern.
    [AT_24-40.CATPart, Aussenring.CATPart, Bugspant.CATPart, D3.CATPart, Ebayspant.CATPart, Fallschirmkammerboden.CATPart, Fallschirmkammerrohr.CATPart, Heckspant.CATPart]
2017-01-17 Simplified model using Xcos (free alternative to Simulink, based on Scilab) for tweaking the PID controller used for thrust vectoring
2017-01-17 New mechanical design, printing for stiff, small tolerance parts and lasercut balsawood for other parts
    [Aussenring.CATPart, Aussenring.stl, Bugspant.CATPart, Chip.CATPart, Crystal.CATPart, Elektronikhalter.CATPart, Elektronikhalter.stl, Elektronikrahmen.CATPart]
2017-01-17 Changes to mechanical design
    [Fallschirmkammerboden.CATPart, Kardanische_Aufhaengung.CATProduct, RTVC.CATProduct, RTVC_Koerper.CATPart, RTVC_Koerper.stp, Servotraeger_oben.CATPart, Servotraeger_unten.CATPart]
2017-10-22 servo test rig Arduino sketch with preliminary results
    [ergebnisse.ods]
2017-10-31 Versuchereihe ausgewertet
    [ergebnisse_versuchsreihe.ods, ergebnisse_versuchsreihe.xlsx, ergebnisse_vorversuche.ods]
2017-10-31 ergebnisse.ods deleted
    [ergebnisse.ods]
2017-10-31 Extended model; includes servo test rig results and liftoff V and alpha variations
2017-11-01 Includes results of preliminary servo test rig runs
    [ergebnisse_vorversuche.ods]
2017-11-03 Determine leg spring sizes to build inertia test rig
    [auslegung_traegheitspruefstand.ods]
2017-11-06 mechanical design iteration v3 uploaded (February 2017, so disregard)
    [Bugspant.CATPart, Elektronikhalter.CATPart, Elektronikhalter.stl, Elektronikhalter_Tesselierung.stl, Elektronikrahmen.CATPart, Elektronikspant.CATPart, Heckspant.CATPart, Laserteile_Balsa_3mm_Blatt__1.dxf]
2017-11-07 idea for using spherical bearing and stepper motors instead of two distinct bearings for each axis and servos
    [Gelenklager_Igus.xlsx, Spindelantrieb_fuer_Verstellung.CATPart]
2017-11-07 added pre-dimensioning for an inertia measuring test rig
    [auslegung_traegheitspruefstand.xlsx]
2017-11-07 framework for a state machine in C++
2017-12-01 Mechanical design v4 (and hopefully final) designed for aircraft plywood and machining, retaining printed engine mount from v3
    [Aussenring.CATPart, Bugspant.CATPart, Bugspant.stp, Chip.CATPart, Crystal.CATPart, Elektronikbaugruppe.CATProduct, Elektronikhalter.CATPart, Elektronikhalter.stl]
2017-12-03 Modified electronics holder; exported parts to be milled as STP; created gcode for these parts
    [Bugspant.FCStd, Elektronikbaugruppe.CATProduct, Elektronikhalter.CATPart, Elektronikhalter.stl, Elektronikspant.CATPart, Elektronikspant.FCStd, Elektronikspant.stp, Elektroniktraeger.CATPart]
2017-12-03 Created paths for entire part layouts using Estlcam
    [fraesteil_layout_245x200.dxf, fraesteil_layout_295x245.dxf]
2017-12-04 possible future design using a spherical bearing
    [Gelenklager_Igus.xlsx, Igus_Pendellager_EGFM_20_T_1.stp]
2017-12-04 uploaded design with carbon fiber motor mount (Mar 2016, so disregard)
    [AT_24-40.CATPart, Aeussere_Aufhaengung.CATPart, Bugspant.CATPart, D3.CATPart, Ebayspant.CATPart, Fallschirmkammerboden.CATPart, Fallschirmkammerrohr.CATPart, Heckspant.CATPart]
2017-12-04 adjusted Arduino and GY-80 position so sensor axes align with motor mount axes
    [Elektronikbaugruppe.CATProduct, Elektronikspant.CATPart, RTVC_v4.CATProduct]
2017-12-20 Created a simple model to practice using a Kalman filter to estimate altitude and predict apogee
    [a.csv, h_est.csv, v.csv, z.csv, z_alti_accel.csv]
2017-12-21 Simple Kalman filter model for attitude observation and control
    [command_exact.csv, gamma_exact.csv, gammadot_exact.csv, gammadot_noise.csv]
2017-12-22 Started drafting a document to develop a combination of Kalman filter and PID controller
2018-01-04 Wrote a short document about PID controller and Kalman filter design
2018-01-05 Kalman filter with only accelerometer data
2018-01-05 Datasheets for sensors and first firmware iteration to determine sensor reading speed
2018-01-05 Wiring for Arduino Nano and GY-80 breakout in a Fritzing document
    [nano_gy80_wiring_HORIZONTALLY_INVERTED.fzz]
2018-01-05 Firmware updated to characterize sensor bias and variance
    [running_average_and_variance.ods]
2018-01-14 Determined Kalman gains from sensor characteristics and simulation. Firmware ready for 'flight' testing.
    [integration_bias.ods]
2018-01-17 Corrected error in iteration
    [integration_bias.ods]
2018-01-17 Modified PID gains to reduce servo reaction and oscillation while keeping a decent step response
    [firmware.ino]
2018-08-26 Model with slow servo; updated firmware (old); startusing quaternions
2019-03-12 add some python scripts that determine how servos need to move to obtain accurate orientation of motor mount
2019-03-12 add link to phone<->arduino communication
2019-11-27 include Z axis in quaternion understanding
2019-12-01 Time flash writing; calculate response to position error
    [performance.ods]
2019-12-01 fix quaternion component calculation; use interrupts and early state machine
    [symbolic_quaternion_multiplication.py]
2019-12-08 write current state and computed reaction to flash, verify by serial output
2019-12-08 add v4 mechanical parts
    [Elektronikbaugruppe.CATProduct, Elektronikspant.CATPart, Motorhalterung.CATProduct, NC_oben.stl, NC_unten.stl, RTVC_v4.CATProduct, Spitze_ogiv_Oberteil.CATPart, Spitze_ogiv_Unterteil.CATPart]
2019-12-09 add PCB part for new mechanical design
    [PCB.CATPart]
2020-02-04 expand new version of mechanical design for vertical electronic integration and 50 mm Klima tube
    [Elektroniktraegerplatte.CATPart, Federkraftklemme_AST_02_3,5.CATPart, Kardanaufhaengung_Aussenring.CATPart, Kardanaufhaengung_Aussenring.stl, Kardanaufhaengung_Innenring.CATPart, Kardanaufhaengung_Innenring.stl, Kardanaufhaengung_Mittelring.CATPart, Kardanaufhaengung_Mittelring.stl]
2021-02-06 Spherical motor mount bearing parts
    [Bodytube.CATPart, Fraesteile.dxf, Kardanaufhaengung_Aussenring.CATPart, Kardanaufhaengung_Innenring.CATPart, Kardanaufhaengung_Innenring.stl, Kardanaufhaengung_Mittelring.CATPart, Kardanaufhaengung_Mittelring.stl, Motorrohr_Anlenkung.CATPart]
2021-02-06 Modify hole sizes in motor mount bearing to accept 4.5 mm bushings and 3 mm pins
    [Kardanaufhaengung_Aussenring.CATPart, Kardanaufhaengung_Aussenring.stl, Kardanaufhaengung_Innenring.CATPart, Kardanaufhaengung_Innenring.stl, Kardanaufhaengung_Mittelring.CATPart, Kardanaufhaengung_Mittelring.stl]
